scenz-dev/superpico-digital/hardware/interface_v2/bias.kicad_sch

## KiCad design hardware/interface_v2/bias.kicad_sch (2026-11-12)

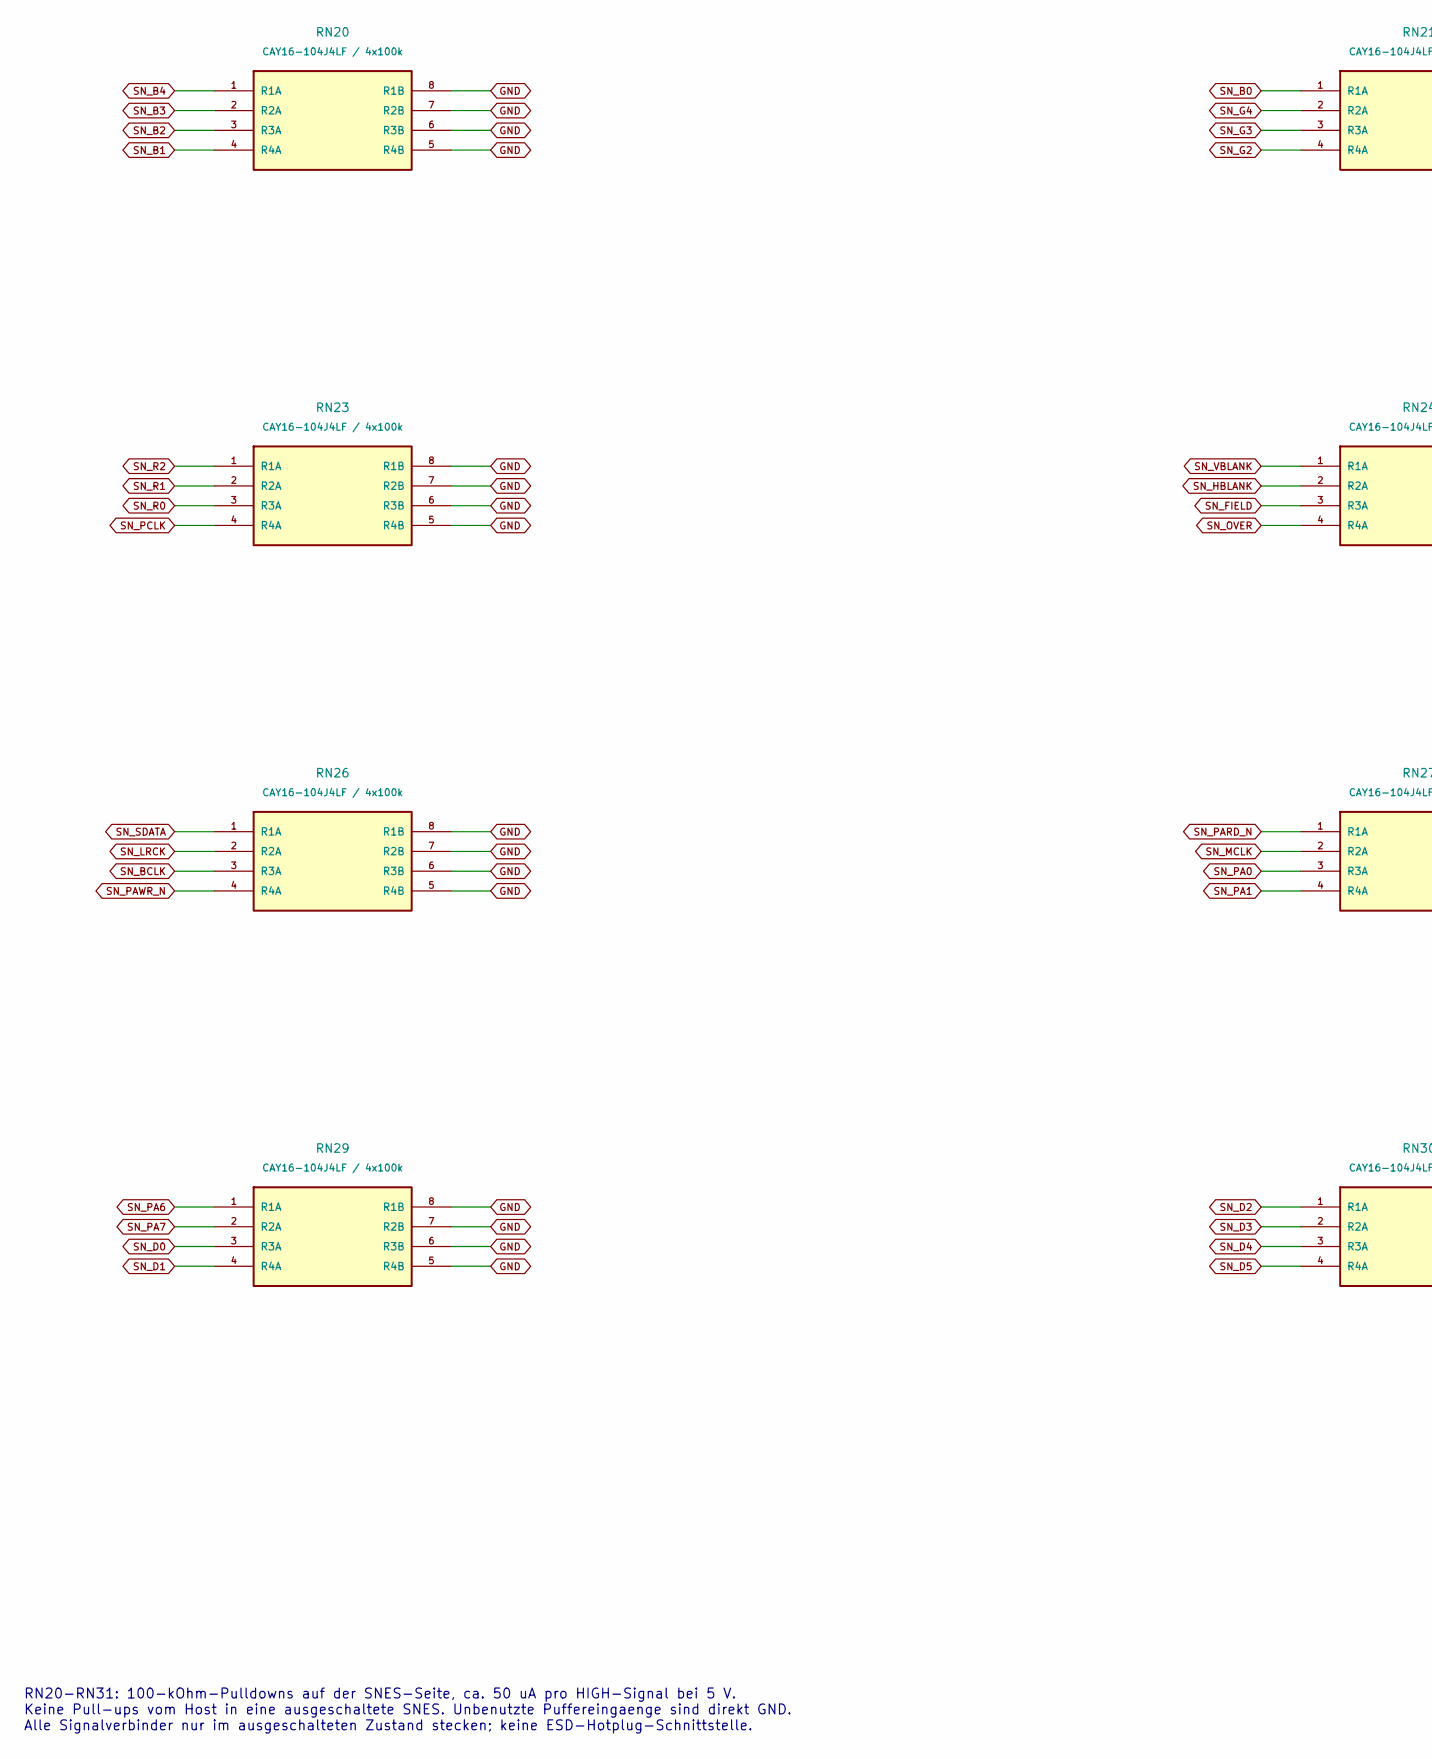
[picture p1: schematic bias.kicad_sch, part in row 1, column 1]

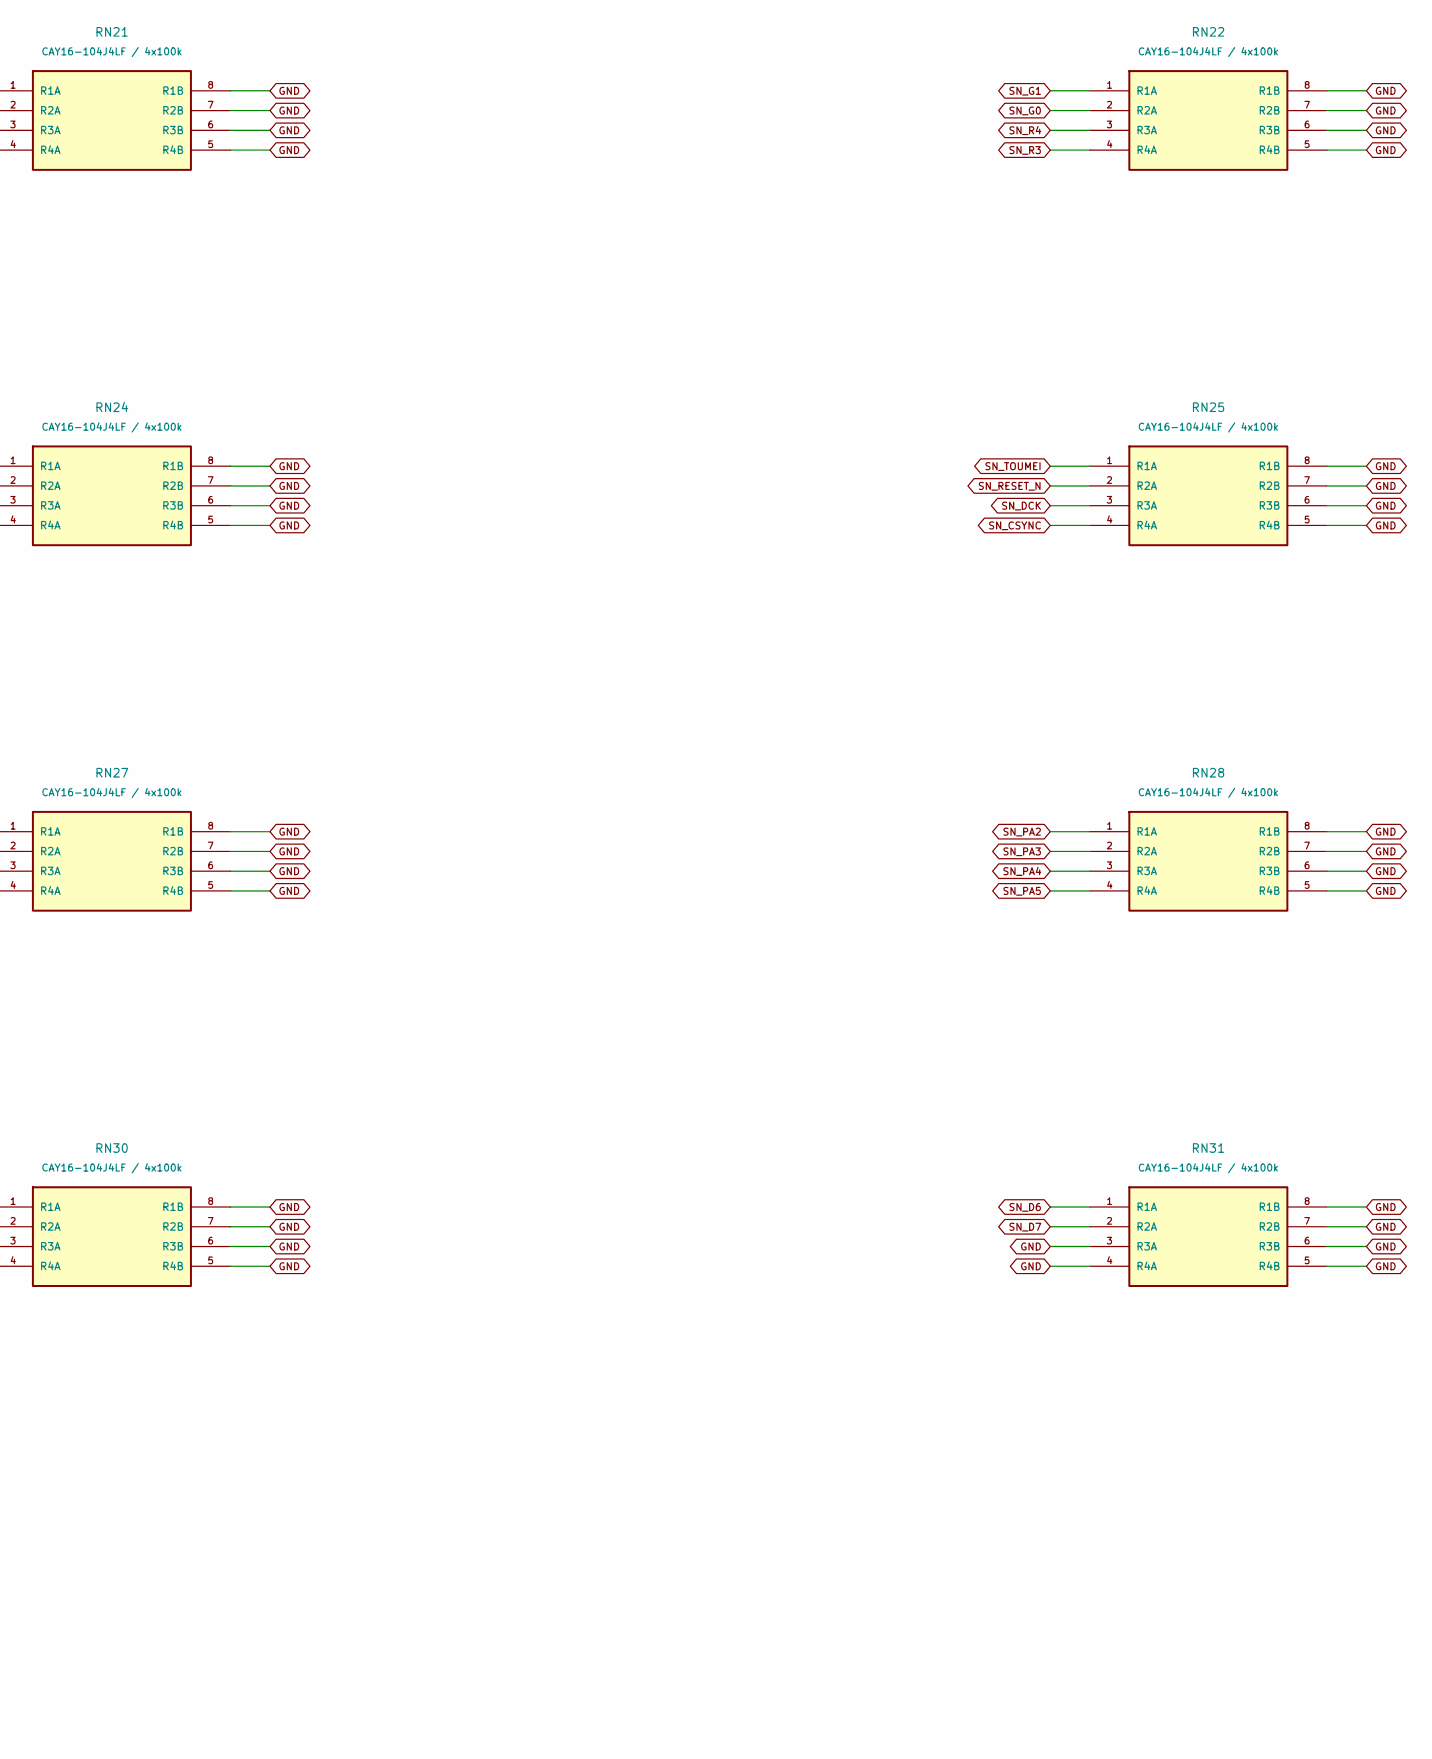
[picture p2: schematic bias.kicad_sch, part in row 1, column 2]

Parts:
RN20, RN21, RN22, RN23, RN24, RN25, RN26, RN27, RN28, RN29, RN30, RN31: CAY16-104J4LF / 4x100k; R_Array_Convex_4x0603

Connections:
GND: RN20.5 (R4B), RN20.6 (R3B), RN20.7 (R2B), RN20.8 (R1B), RN21.5 (R4B), RN21.6 (R3B), RN21.7 (R2B), RN21.8 (R1B), RN22.5 (R4B), RN22.6 (R3B), RN22.7 (R2B), RN22.8 (R1B), RN23.5 (R4B), RN23.6 (R3B), RN23.7 (R2B), RN23.8 (R1B), RN24.5 (R4B), RN24.6 (R3B), RN24.7 (R2B), RN24.8 (R1B), RN25.5 (R4B), RN25.6 (R3B), RN25.7 (R2B), RN25.8 (R1B), RN26.5 (R4B), RN26.6 (R3B), RN26.7 (R2B), RN26.8 (R1B), RN27.5 (R4B), RN27.6 (R3B), RN27.7 (R2B), RN27.8 (R1B), RN28.5 (R4B), RN28.6 (R3B), RN28.7 (R2B), RN28.8 (R1B), RN29.5 (R4B), RN29.6 (R3B), RN29.7 (R2B), RN29.8 (R1B), RN30.5 (R4B), RN30.6 (R3B), RN30.7 (R2B), RN30.8 (R1B), RN31.3 (R3A), RN31.4 (R4A), RN31.5 (R4B), RN31.6 (R3B), RN31.7 (R2B), RN31.8 (R1B)
SN_B0: RN21.1 (R1A)
SN_B1: RN20.4 (R4A)
SN_B2: RN20.3 (R3A)
SN_B3: RN20.2 (R2A)
SN_B4: RN20.1 (R1A)
SN_BCLK: RN26.3 (R3A)
SN_CSYNC: RN25.4 (R4A)
SN_D0: RN29.3 (R3A)
SN_D1: RN29.4 (R4A)
SN_D2: RN30.1 (R1A)
SN_D3: RN30.2 (R2A)
SN_D4: RN30.3 (R3A)
SN_D5: RN30.4 (R4A)
SN_D6: RN31.1 (R1A)
SN_D7: RN31.2 (R2A)
SN_DCK: RN25.3 (R3A)
SN_FIELD: RN24.3 (R3A)
SN_G0: RN22.2 (R2A)
SN_G1: RN22.1 (R1A)
SN_G2: RN21.4 (R4A)
SN_G3: RN21.3 (R3A)
SN_G4: RN21.2 (R2A)
SN_HBLANK: RN24.2 (R2A)
SN_LRCK: RN26.2 (R2A)
SN_MCLK: RN27.2 (R2A)
SN_OVER: RN24.4 (R4A)
SN_PA0: RN27.3 (R3A)
SN_PA1: RN27.4 (R4A)
SN_PA2: RN28.1 (R1A)
SN_PA3: RN28.2 (R2A)
SN_PA4: RN28.3 (R3A)
SN_PA5: RN28.4 (R4A)
SN_PA6: RN29.1 (R1A)
SN_PA7: RN29.2 (R2A)
SN_PARD_N: RN27.1 (R1A)
SN_PAWR_N: RN26.4 (R4A)
SN_PCLK: RN23.4 (R4A)
SN_R0: RN23.3 (R3A)
SN_R1: RN23.2 (R2A)
SN_R2: RN23.1 (R1A)
SN_R3: RN22.4 (R4A)
SN_R4: RN22.3 (R3A)
SN_RESET_N: RN25.2 (R2A)
SN_SDATA: RN26.1 (R1A)
SN_TOUMEI: RN25.1 (R1A)
SN_VBLANK: RN24.1 (R1A)

Notes on the sheet:
RN20-RN31: 100-kOhm-Pulldowns auf der SNES-Seite, ca. 50 uA pro HIGH-Signal bei 5 V. Keine Pull-ups vom Host in eine ausgeschaltete SNES. Unbenutzte Puffereingaenge sind direkt GND. Alle Signalverbinder nur im ausgeschalteten Zustand stecken; keine ESD-Hotplug-Schnittstelle.
