scenz-dev/superpico-digital/hardware/interface_v2/bus.kicad_sch

## KiCad design hardware/interface_v2/bus.kicad_sch (2026-11-12)

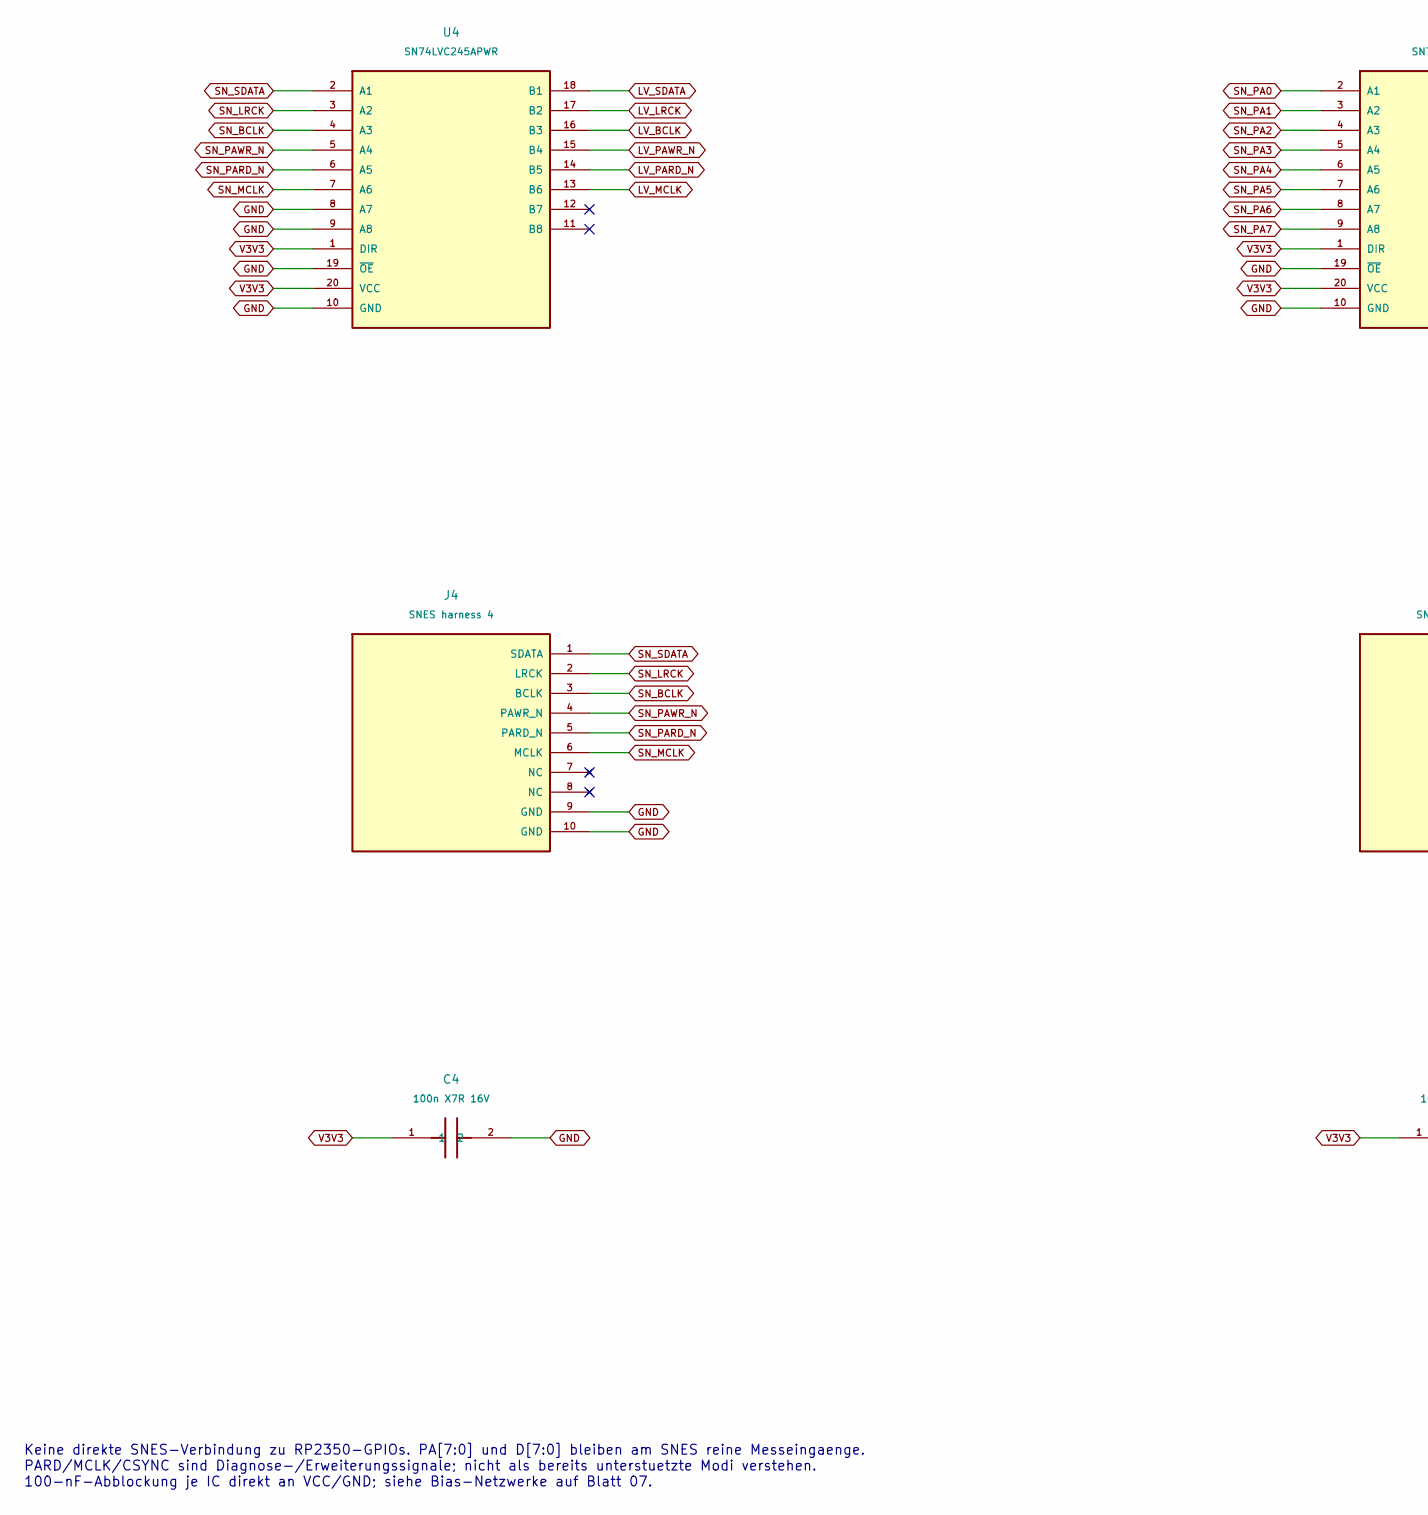
[picture p3: schematic bus.kicad_sch, part in row 1, column 1]

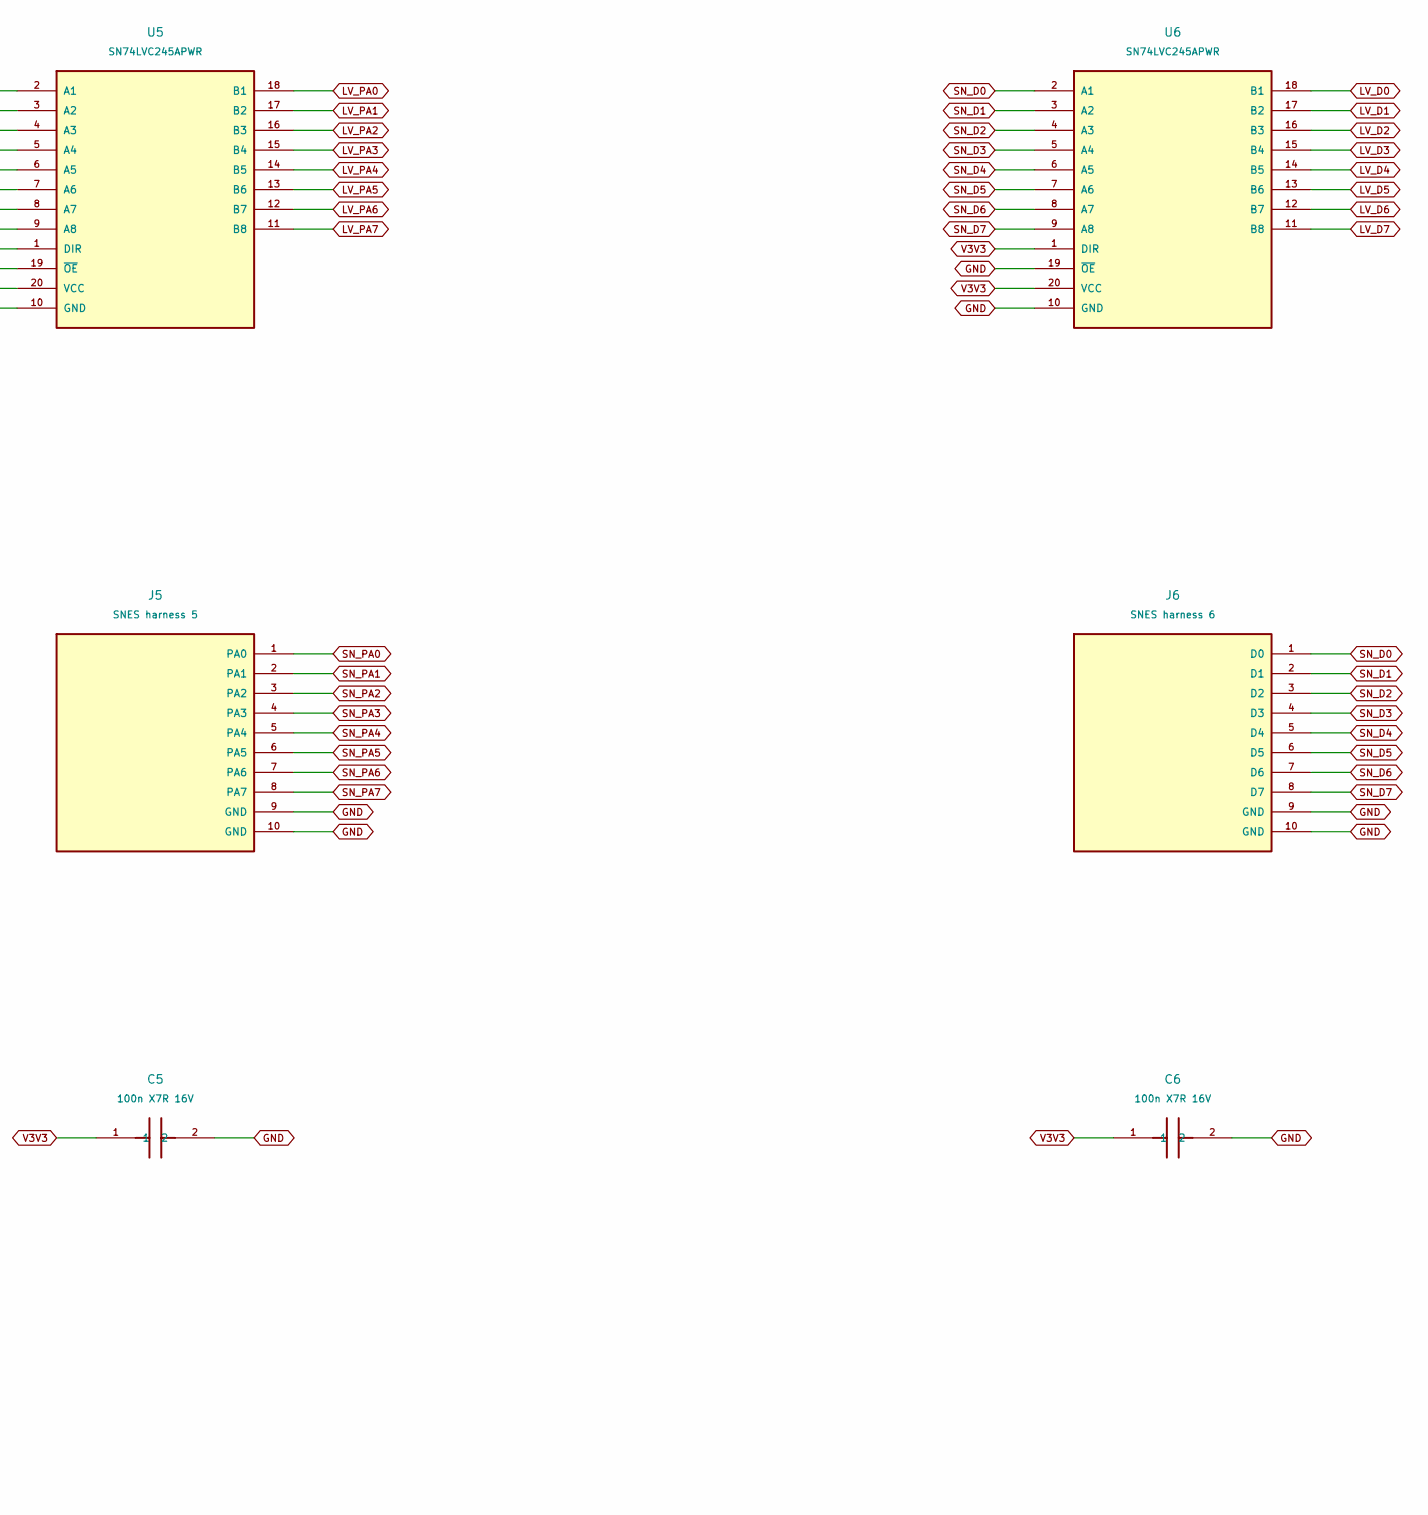
[picture p4: schematic bus.kicad_sch, part in row 1, column 2]

Parts:
C4, C5, C6: 100n X7R 16V; C_0603_1608Metric
J4: SNES harness 4; PinHeader_2x05_P2.54mm_Vertical
J5: SNES harness 5; PinHeader_2x05_P2.54mm_Vertical
J6: SNES harness 6; PinHeader_2x05_P2.54mm_Vertical
U4, U5, U6: SN74LVC245APWR; TSSOP-20_4.4x6.5mm_P0.65mm

Connections:
GND: C4.2, C5.2, C6.2, J4.9 (GND), J4.10 (GND), J5.9 (GND), J5.10 (GND), J6.9 (GND), J6.10 (GND), U4.8 (A7), U4.9 (A8), U4.10 (GND), U4.19 (~OE), U5.10 (GND), U5.19 (~OE), U6.10 (GND), U6.19 (~OE)
LV_BCLK: U4.16 (B3)
LV_D0: U6.18 (B1)
LV_D1: U6.17 (B2)
LV_D2: U6.16 (B3)
LV_D3: U6.15 (B4)
LV_D4: U6.14 (B5)
LV_D5: U6.13 (B6)
LV_D6: U6.12 (B7)
LV_D7: U6.11 (B8)
LV_LRCK: U4.17 (B2)
LV_MCLK: U4.13 (B6)
LV_PA0: U5.18 (B1)
LV_PA1: U5.17 (B2)
LV_PA2: U5.16 (B3)
LV_PA3: U5.15 (B4)
LV_PA4: U5.14 (B5)
LV_PA5: U5.13 (B6)
LV_PA6: U5.12 (B7)
LV_PA7: U5.11 (B8)
LV_PARD_N: U4.14 (B5)
LV_PAWR_N: U4.15 (B4)
LV_SDATA: U4.18 (B1)
SN_BCLK: J4.3 (BCLK), U4.4 (A3)
SN_D0: J6.1 (D0), U6.2 (A1)
SN_D1: J6.2 (D1), U6.3 (A2)
SN_D2: J6.3 (D2), U6.4 (A3)
SN_D3: J6.4 (D3), U6.5 (A4)
SN_D4: J6.5 (D4), U6.6 (A5)
SN_D5: J6.6 (D5), U6.7 (A6)
SN_D6: J6.7 (D6), U6.8 (A7)
SN_D7: J6.8 (D7), U6.9 (A8)
SN_LRCK: J4.2 (LRCK), U4.3 (A2)
SN_MCLK: J4.6 (MCLK), U4.7 (A6)
SN_PA0: J5.1 (PA0), U5.2 (A1)
SN_PA1: J5.2 (PA1), U5.3 (A2)
SN_PA2: J5.3 (PA2), U5.4 (A3)
SN_PA3: J5.4 (PA3), U5.5 (A4)
SN_PA4: J5.5 (PA4), U5.6 (A5)
SN_PA5: J5.6 (PA5), U5.7 (A6)
SN_PA6: J5.7 (PA6), U5.8 (A7)
SN_PA7: J5.8 (PA7), U5.9 (A8)
SN_PARD_N: J4.5 (PARD_N), U4.6 (A5)
SN_PAWR_N: J4.4 (PAWR_N), U4.5 (A4)
SN_SDATA: J4.1 (SDATA), U4.2 (A1)
V3V3: C4.1, C5.1, C6.1, U4.1 (DIR), U4.20 (VCC), U5.1 (DIR), U5.20 (VCC), U6.1 (DIR), U6.20 (VCC)

Notes on the sheet:
Keine direkte SNES-Verbindung zu RP2350-GPIOs. PA[7:0] und D[7:0] bleiben am SNES reine Messeingaenge. PARD/MCLK/CSYNC sind Diagnose-/Erweiterungssignale; nicht als bereits unterstuetzte Modi verstehen. 100-nF-Abblockung je IC direkt an VCC/GND; siehe Bias-Netzwerke auf Blatt 07.
