scenz-dev/superpico-digital/hardware/interface_v2/decode.kicad_sch

## KiCad design hardware/interface_v2/decode.kicad_sch (2026-11-12)

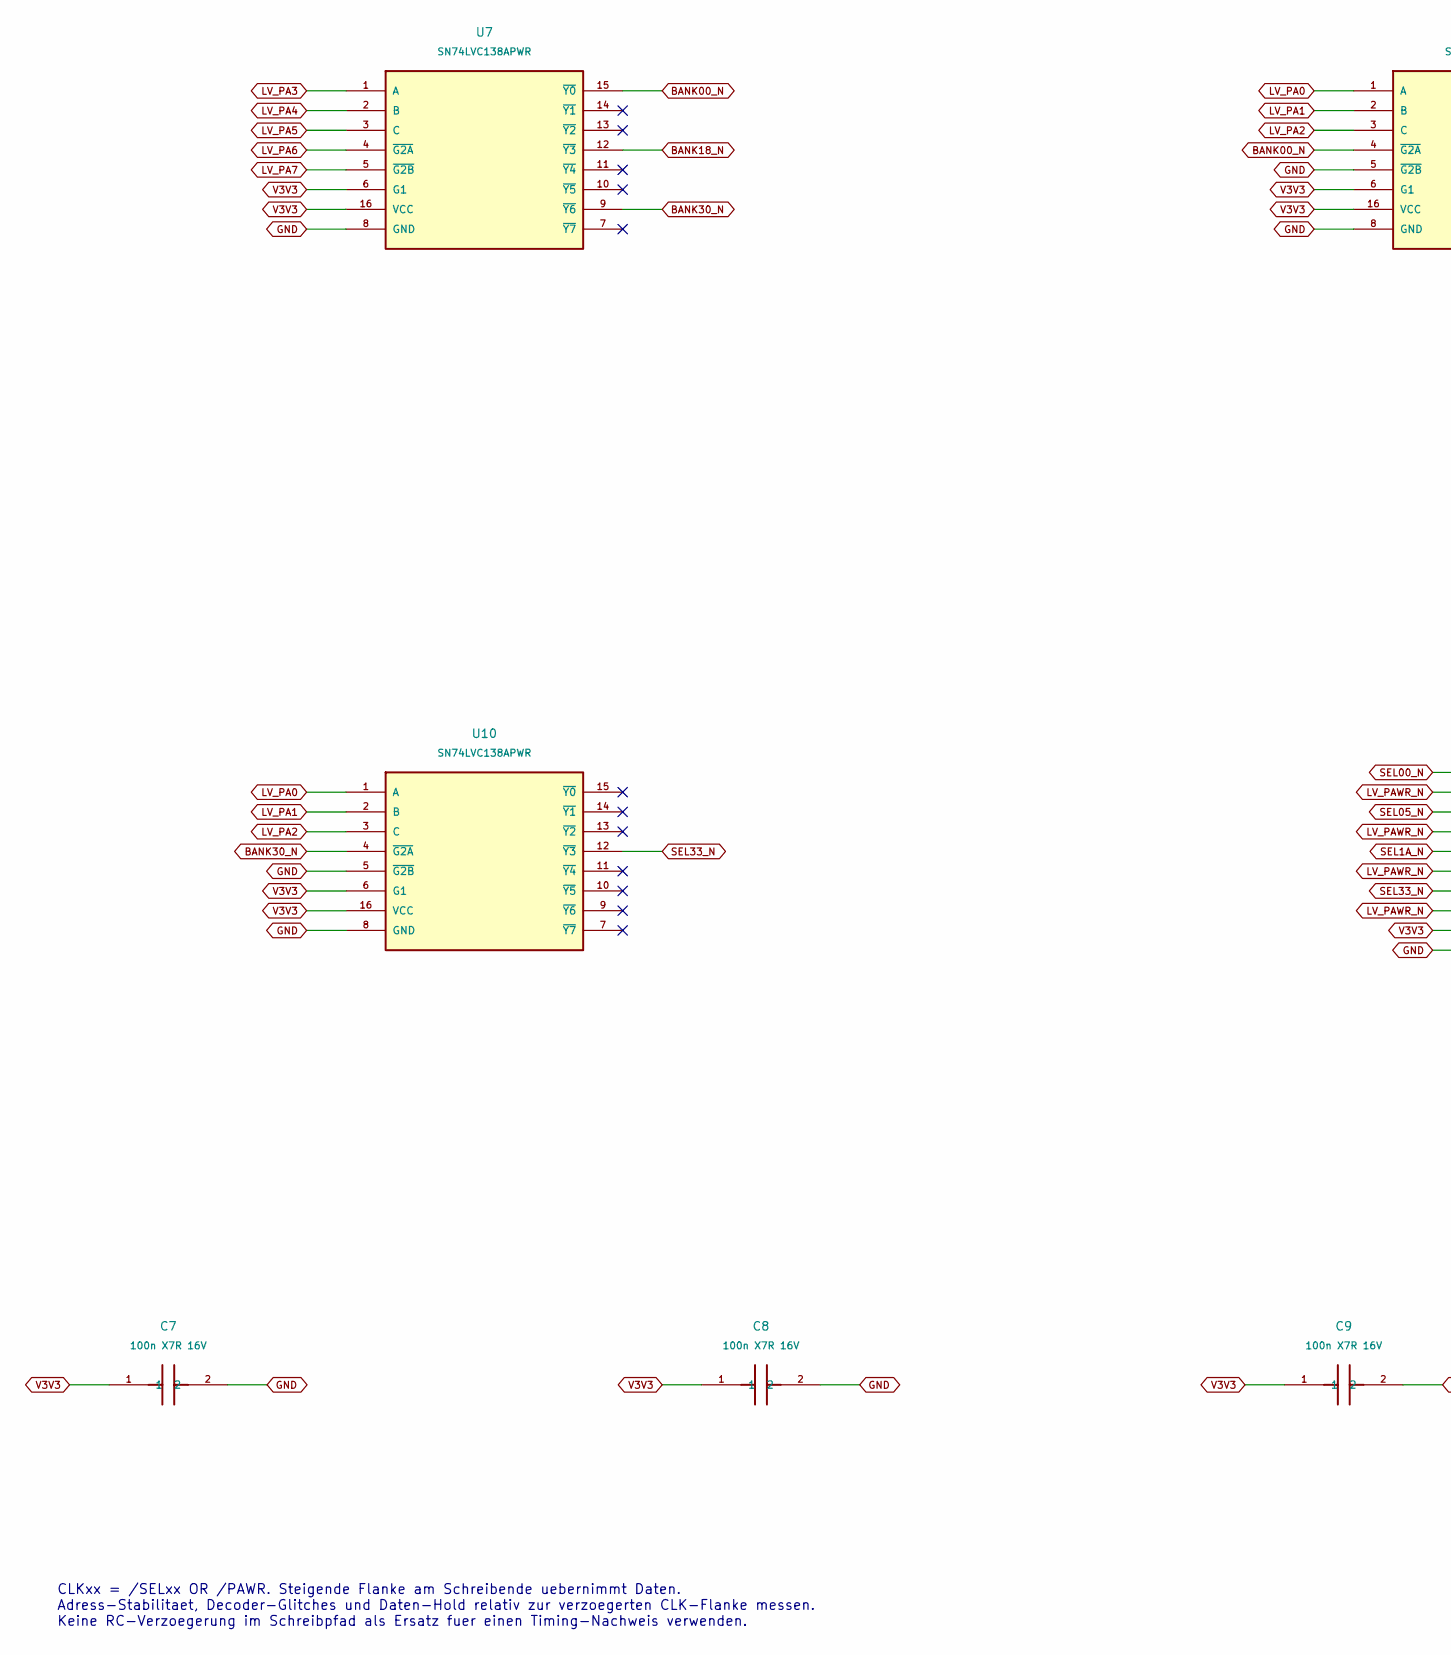
[picture p5: schematic decode.kicad_sch, part in row 1, column 1]

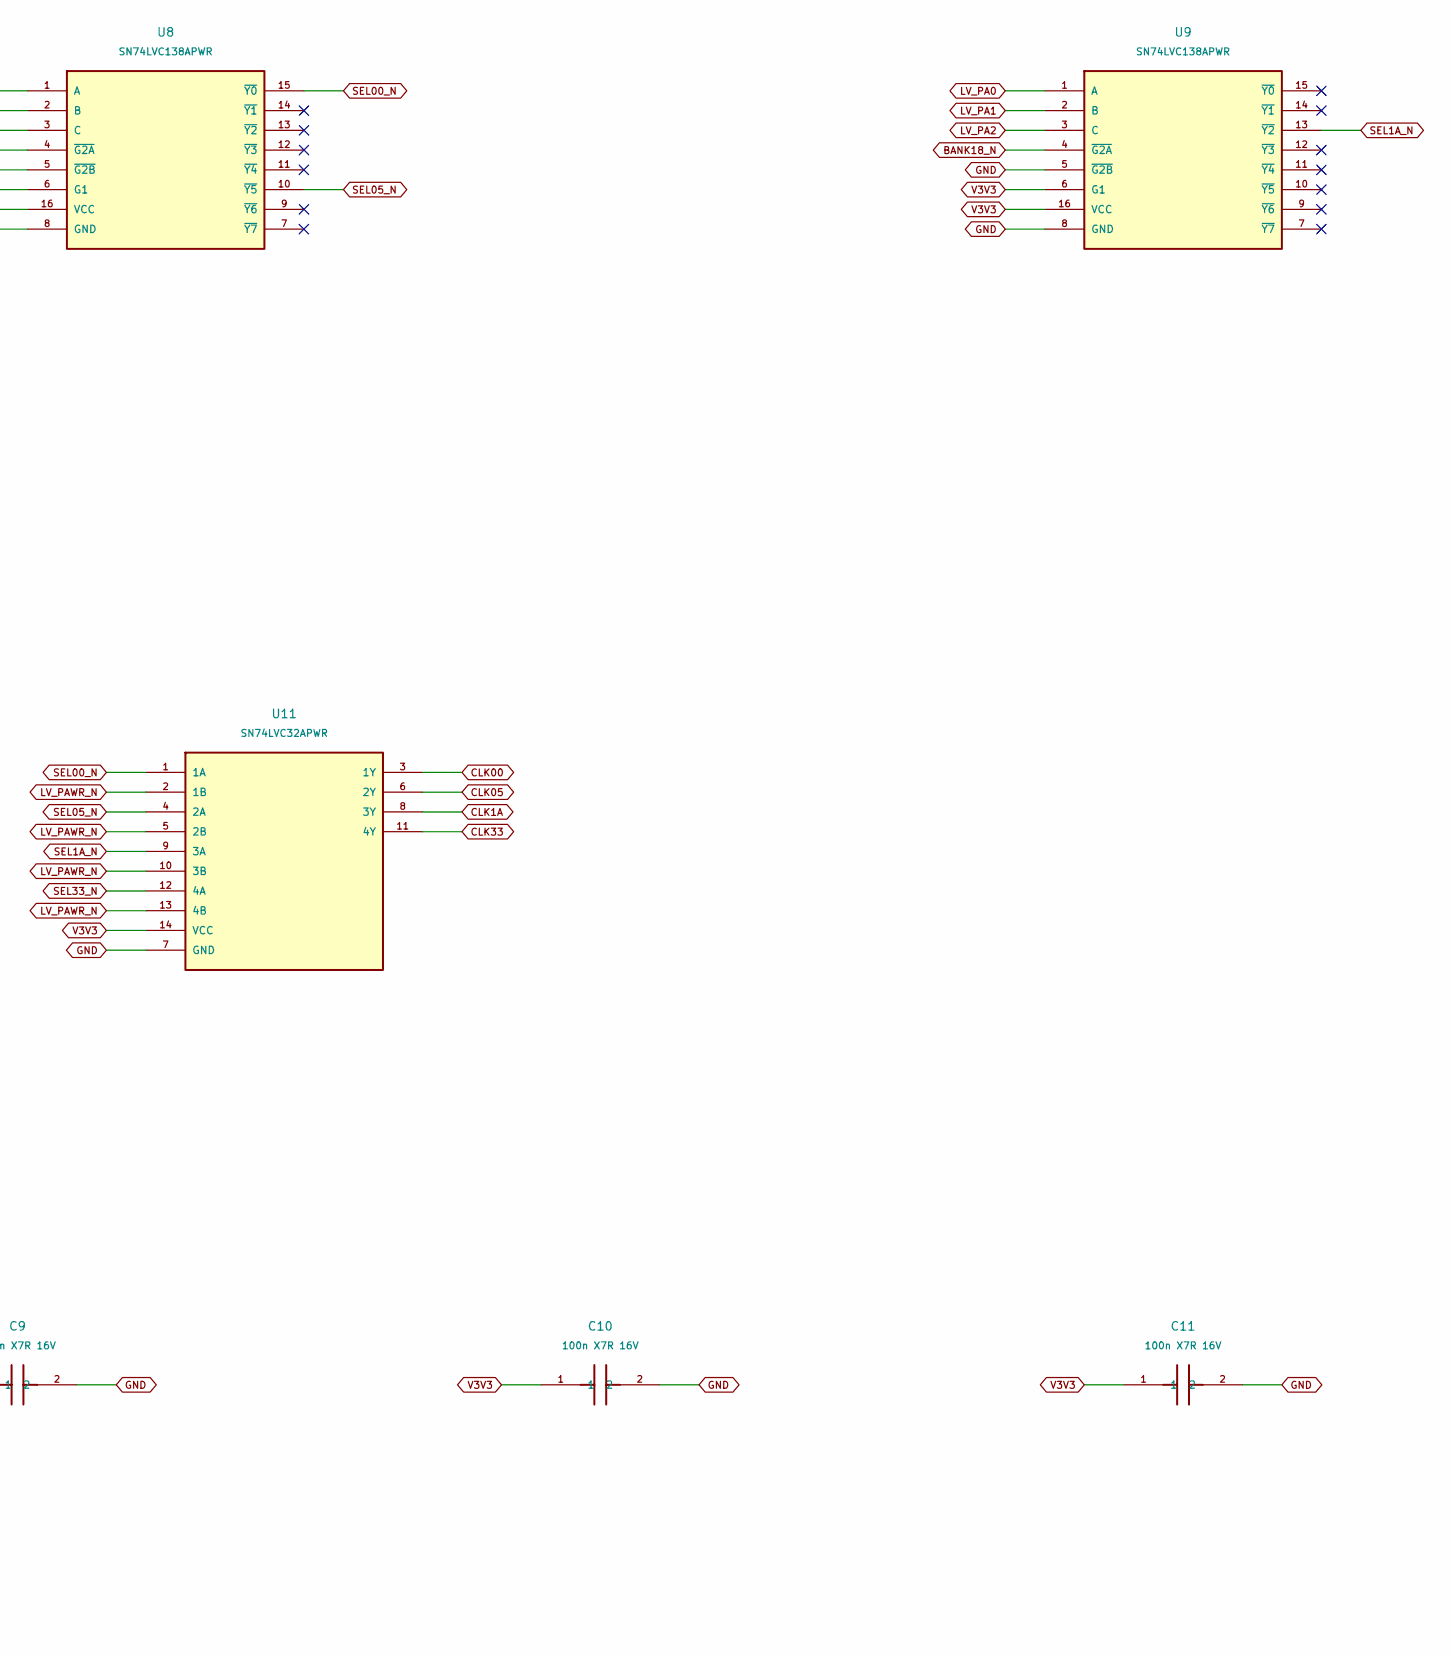
[picture p6: schematic decode.kicad_sch, part in row 1, column 2]

Parts:
C7, C8, C9, C10, C11: 100n X7R 16V; C_0603_1608Metric
U7, U8, U9, U10: SN74LVC138APWR; TSSOP-16_4.4x5mm_P0.65mm
U11: SN74LVC32APWR; TSSOP-14_4.4x5mm_P0.65mm

Connections:
BANK00_N: U7.15 (~Y0), U8.4 (~G2A)
BANK18_N: U7.12 (~Y3), U9.4 (~G2A)
BANK30_N: U7.9 (~Y6), U10.4 (~G2A)
CLK00: U11.3 (1Y)
CLK1A: U11.8 (3Y)
CLK05: U11.6 (2Y)
CLK33: U11.11 (4Y)
GND: C7.2, C8.2, C9.2, C10.2, C11.2, U7.8 (GND), U8.5 (~G2B), U8.8 (GND), U9.5 (~G2B), U9.8 (GND), U10.5 (~G2B), U10.8 (GND), U11.7 (GND)
LV_PA0: U8.1 (A), U9.1 (A), U10.1 (A)
LV_PA1: U8.2 (B), U9.2 (B), U10.2 (B)
LV_PA2: U8.3 (C), U9.3 (C), U10.3 (C)
LV_PA3: U7.1 (A)
LV_PA4: U7.2 (B)
LV_PA5: U7.3 (C)
LV_PA6: U7.4 (~G2A)
LV_PA7: U7.5 (~G2B)
LV_PAWR_N: U11.2 (1B), U11.5 (2B), U11.10 (3B), U11.13 (4B)
SEL00_N: U8.15 (~Y0), U11.1 (1A)
SEL1A_N: U9.13 (~Y2), U11.9 (3A)
SEL05_N: U8.10 (~Y5), U11.4 (2A)
SEL33_N: U10.12 (~Y3), U11.12 (4A)
V3V3: C7.1, C8.1, C9.1, C10.1, C11.1, U7.6 (G1), U7.16 (VCC), U8.6 (G1), U8.16 (VCC), U9.6 (G1), U9.16 (VCC), U10.6 (G1), U10.16 (VCC), U11.14 (VCC)

Notes on the sheet:
CLKxx = /SELxx OR /PAWR. Steigende Flanke am Schreibende uebernimmt Daten. Adress-Stabilitaet, Decoder-Glitches und Daten-Hold relativ zur verzoegerten CLK-Flanke messen. Keine RC-Verzoegerung im Schreibpfad als Ersatz fuer einen Timing-Nachweis verwenden.
