scenz-dev/superpico-digital/hardware/interface_v2/host.kicad_sch

## KiCad design hardware/interface_v2/host.kicad_sch (2026-11-12)

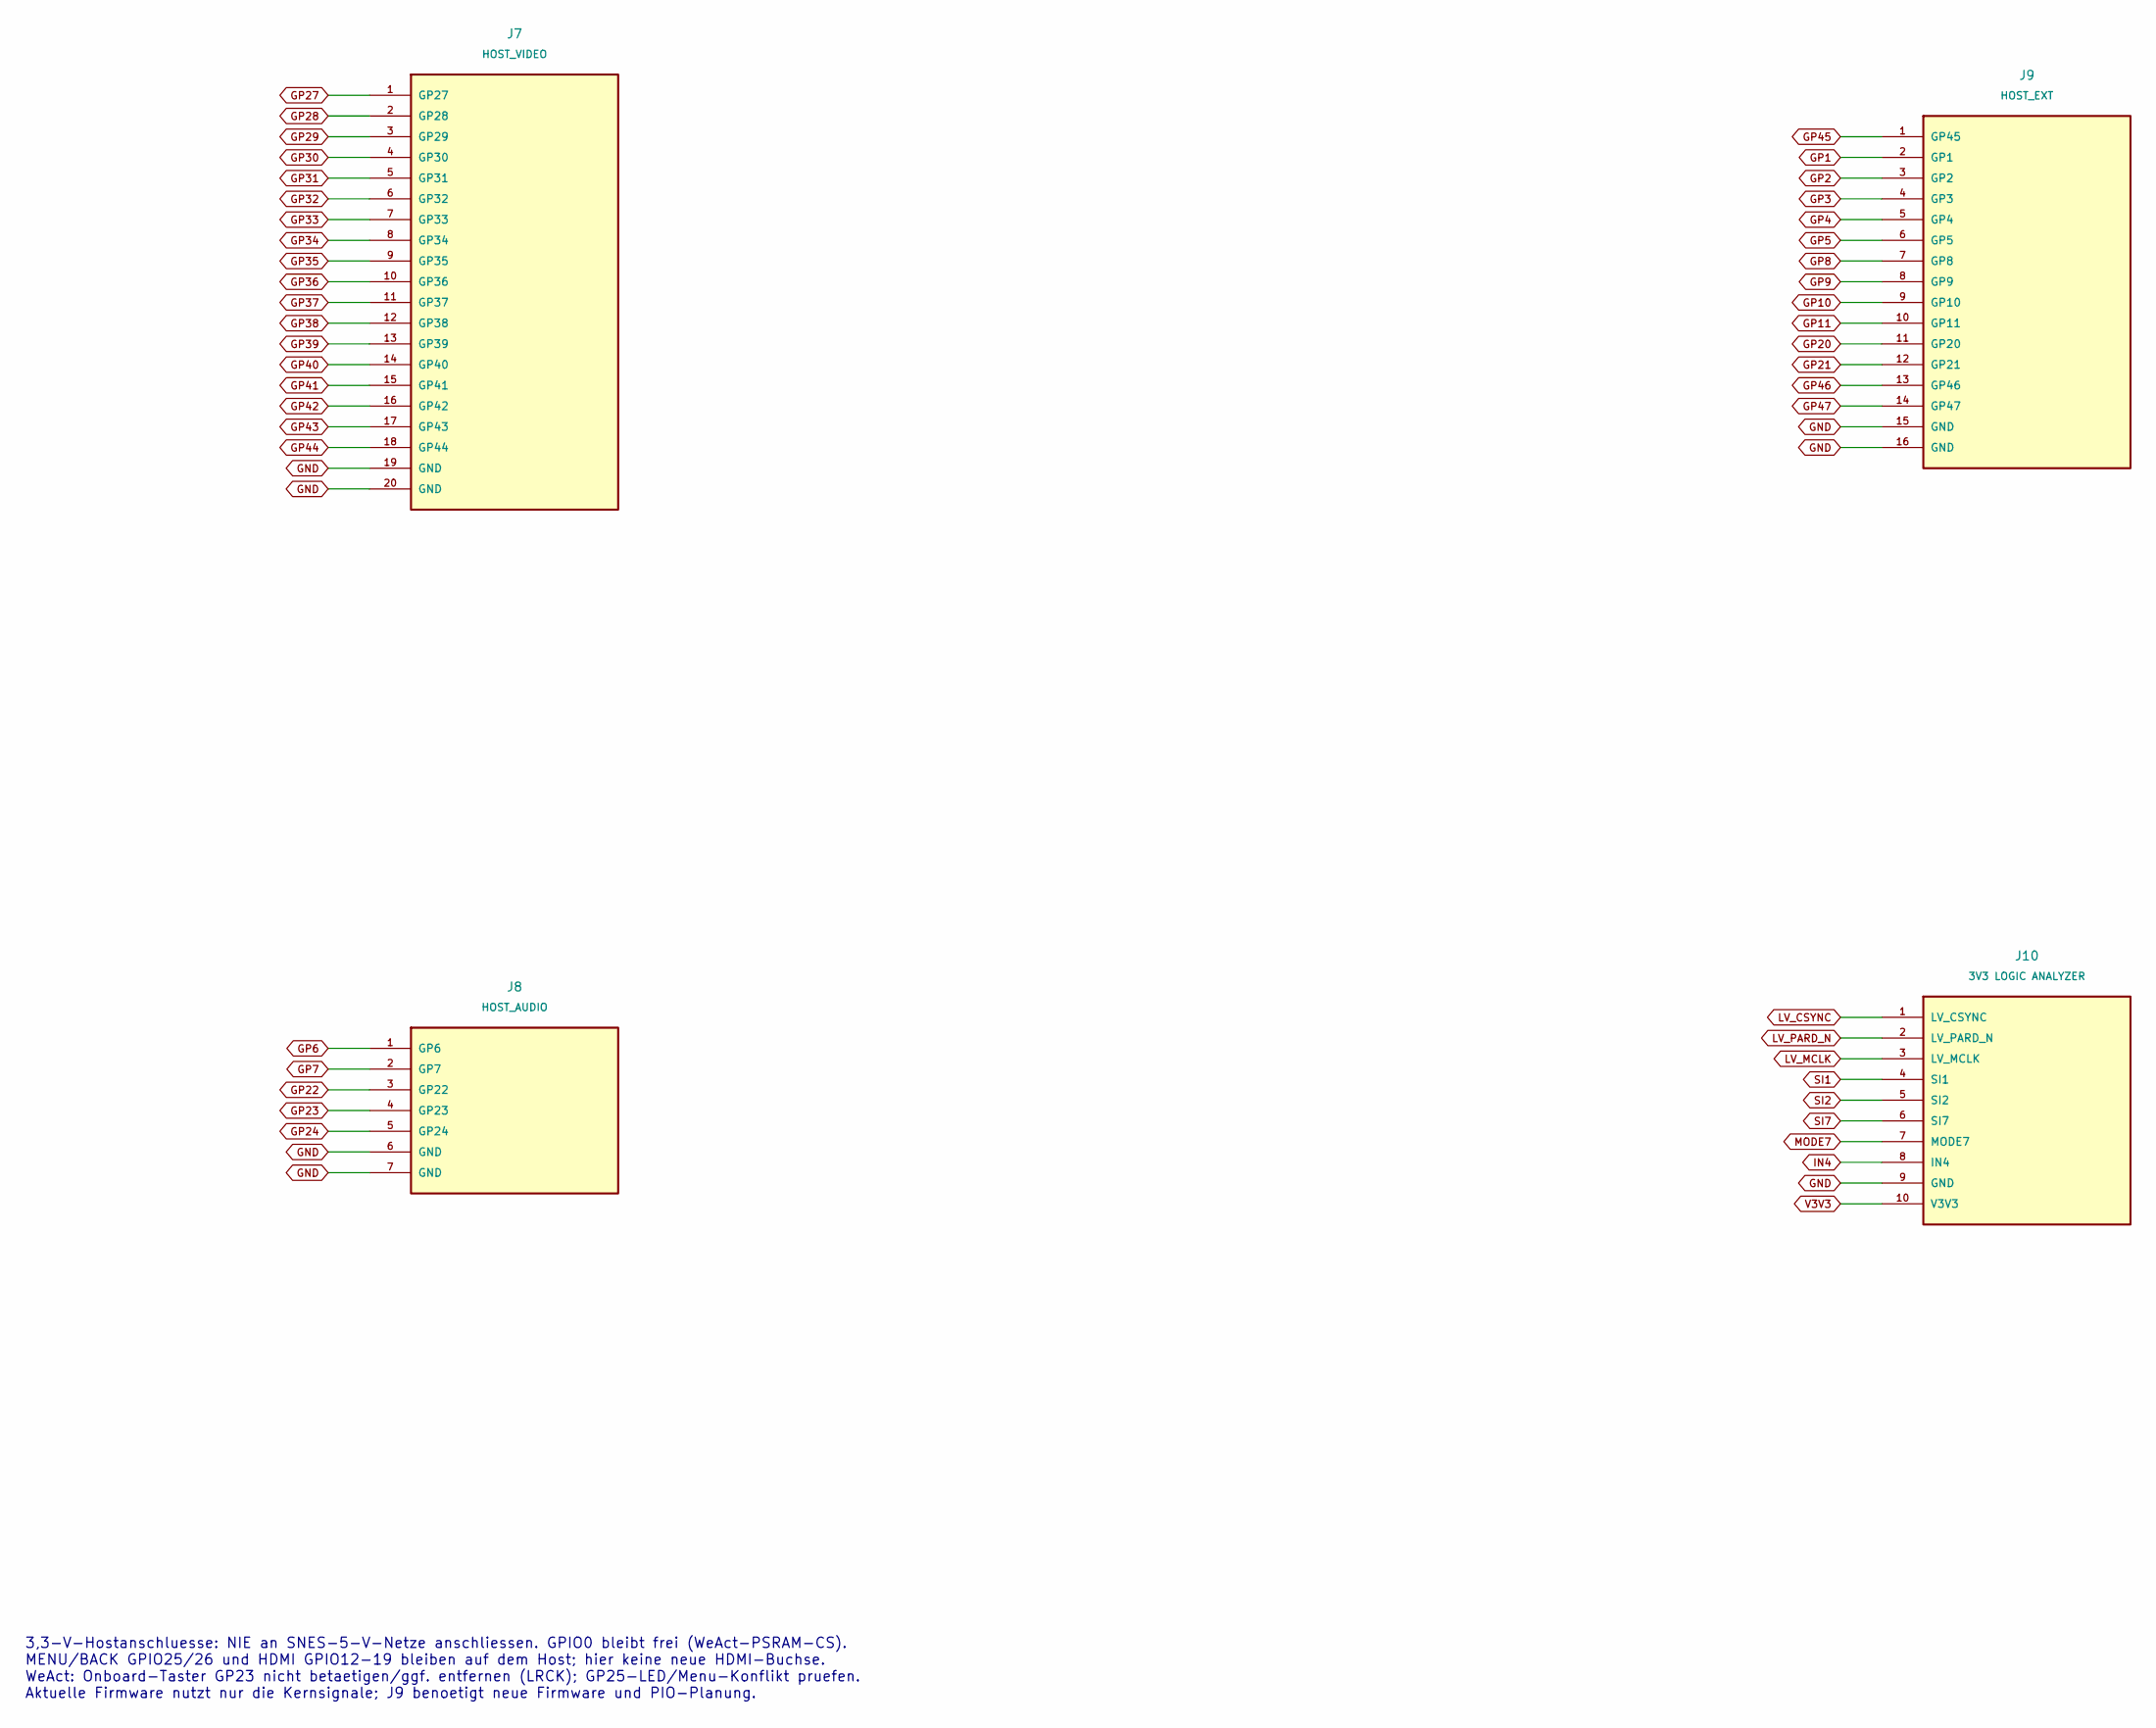
[picture p7: schematic host.kicad_sch]

Parts:
J7: HOST_VIDEO; PinHeader_2x10_P2.54mm_Vertical
J8: HOST_AUDIO; PinHeader_1x07_P2.54mm_Vertical
J9: HOST_EXT; PinHeader_2x08_P2.54mm_Vertical
J10: 3V3 LOGIC ANALYZER; PinHeader_2x05_P2.54mm_Vertical

Connections:
GND: J7.19 (GND), J7.20 (GND), J8.6 (GND), J8.7 (GND), J9.15 (GND), J9.16 (GND), J10.9 (GND)
GP1: J9.2 (GP1)
GP2: J9.3 (GP2)
GP3: J9.4 (GP3)
GP4: J9.5 (GP4)
GP5: J9.6 (GP5)
GP6: J8.1 (GP6)
GP7: J8.2 (GP7)
GP8: J9.7 (GP8)
GP9: J9.8 (GP9)
GP10: J9.9 (GP10)
GP11: J9.10 (GP11)
GP20: J9.11 (GP20)
GP21: J9.12 (GP21)
GP22: J8.3 (GP22)
GP23: J8.4 (GP23)
GP24: J8.5 (GP24)
GP27: J7.1 (GP27)
GP28: J7.2 (GP28)
GP29: J7.3 (GP29)
GP30: J7.4 (GP30)
GP31: J7.5 (GP31)
GP32: J7.6 (GP32)
GP33: J7.7 (GP33)
GP34: J7.8 (GP34)
GP35: J7.9 (GP35)
GP36: J7.10 (GP36)
GP37: J7.11 (GP37)
GP38: J7.12 (GP38)
GP39: J7.13 (GP39)
GP40: J7.14 (GP40)
GP41: J7.15 (GP41)
GP42: J7.16 (GP42)
GP43: J7.17 (GP43)
GP44: J7.18 (GP44)
GP45: J9.1 (GP45)
GP46: J9.13 (GP46)
GP47: J9.14 (GP47)
IN4: J10.8 (IN4)
LV_CSYNC: J10.1 (LV_CSYNC)
LV_MCLK: J10.3 (LV_MCLK)
LV_PARD_N: J10.2 (LV_PARD_N)
MODE7: J10.7 (MODE7)
SI1: J10.4 (SI1)
SI2: J10.5 (SI2)
SI7: J10.6 (SI7)
V3V3: J10.10 (V3V3)

Notes on the sheet:
3,3-V-Hostanschluesse: NIE an SNES-5-V-Netze anschliessen. GPIO0 bleibt frei (WeAct-PSRAM-CS). MENU/BACK GPIO25/26 und HDMI GPIO12-19 bleiben auf dem Host; hier keine neue HDMI-Buchse. WeAct: Onboard-Taster GP23 nicht betaetigen/ggf. entfernen (LRCK); GP25-LED/Menu-Konflikt pruefen. Aktuelle Firmwa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
