scenz-dev/superpico-digital/hardware/interface_v2/latches.kicad_sch

## KiCad design hardware/interface_v2/latches.kicad_sch (2026-11-12)

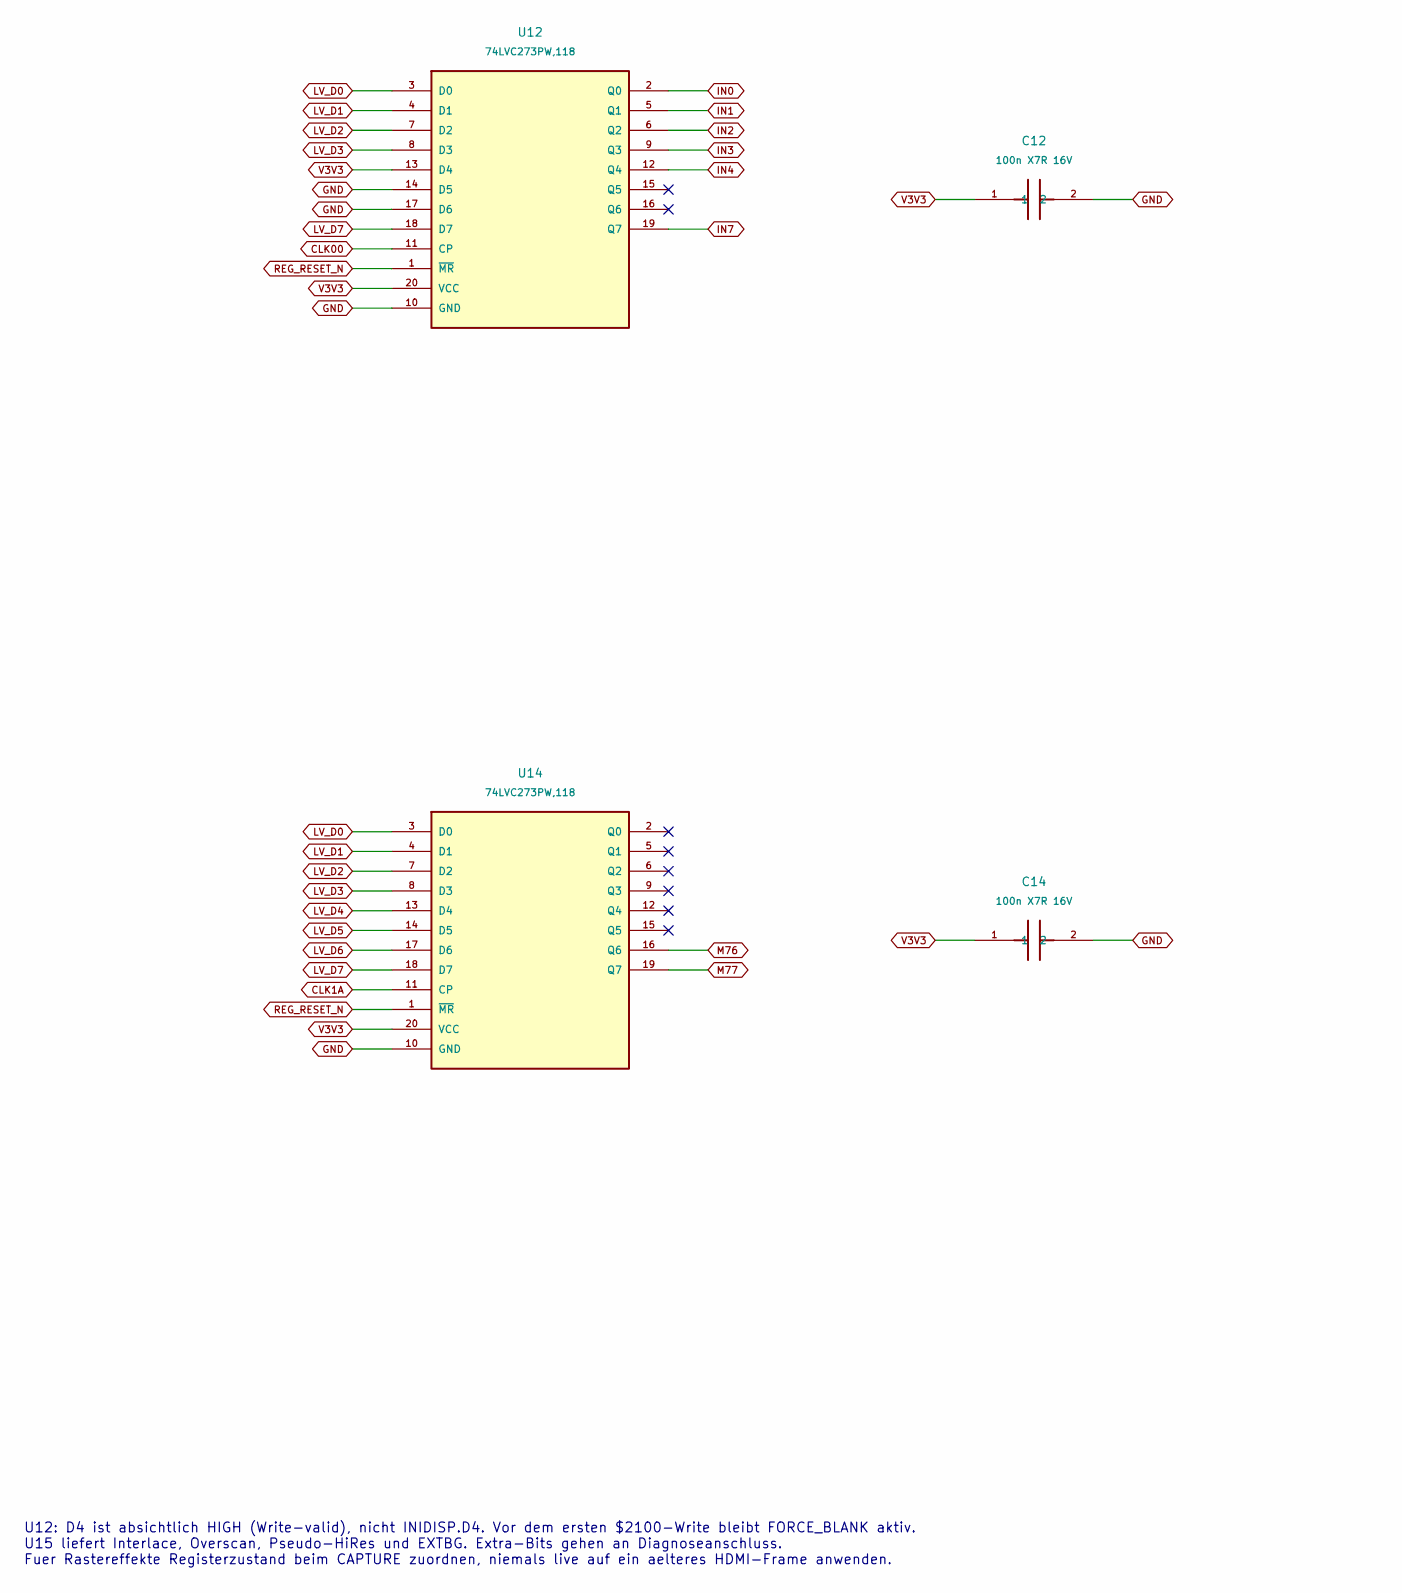
[picture p8: schematic latches.kicad_sch, part in row 1, column 1]

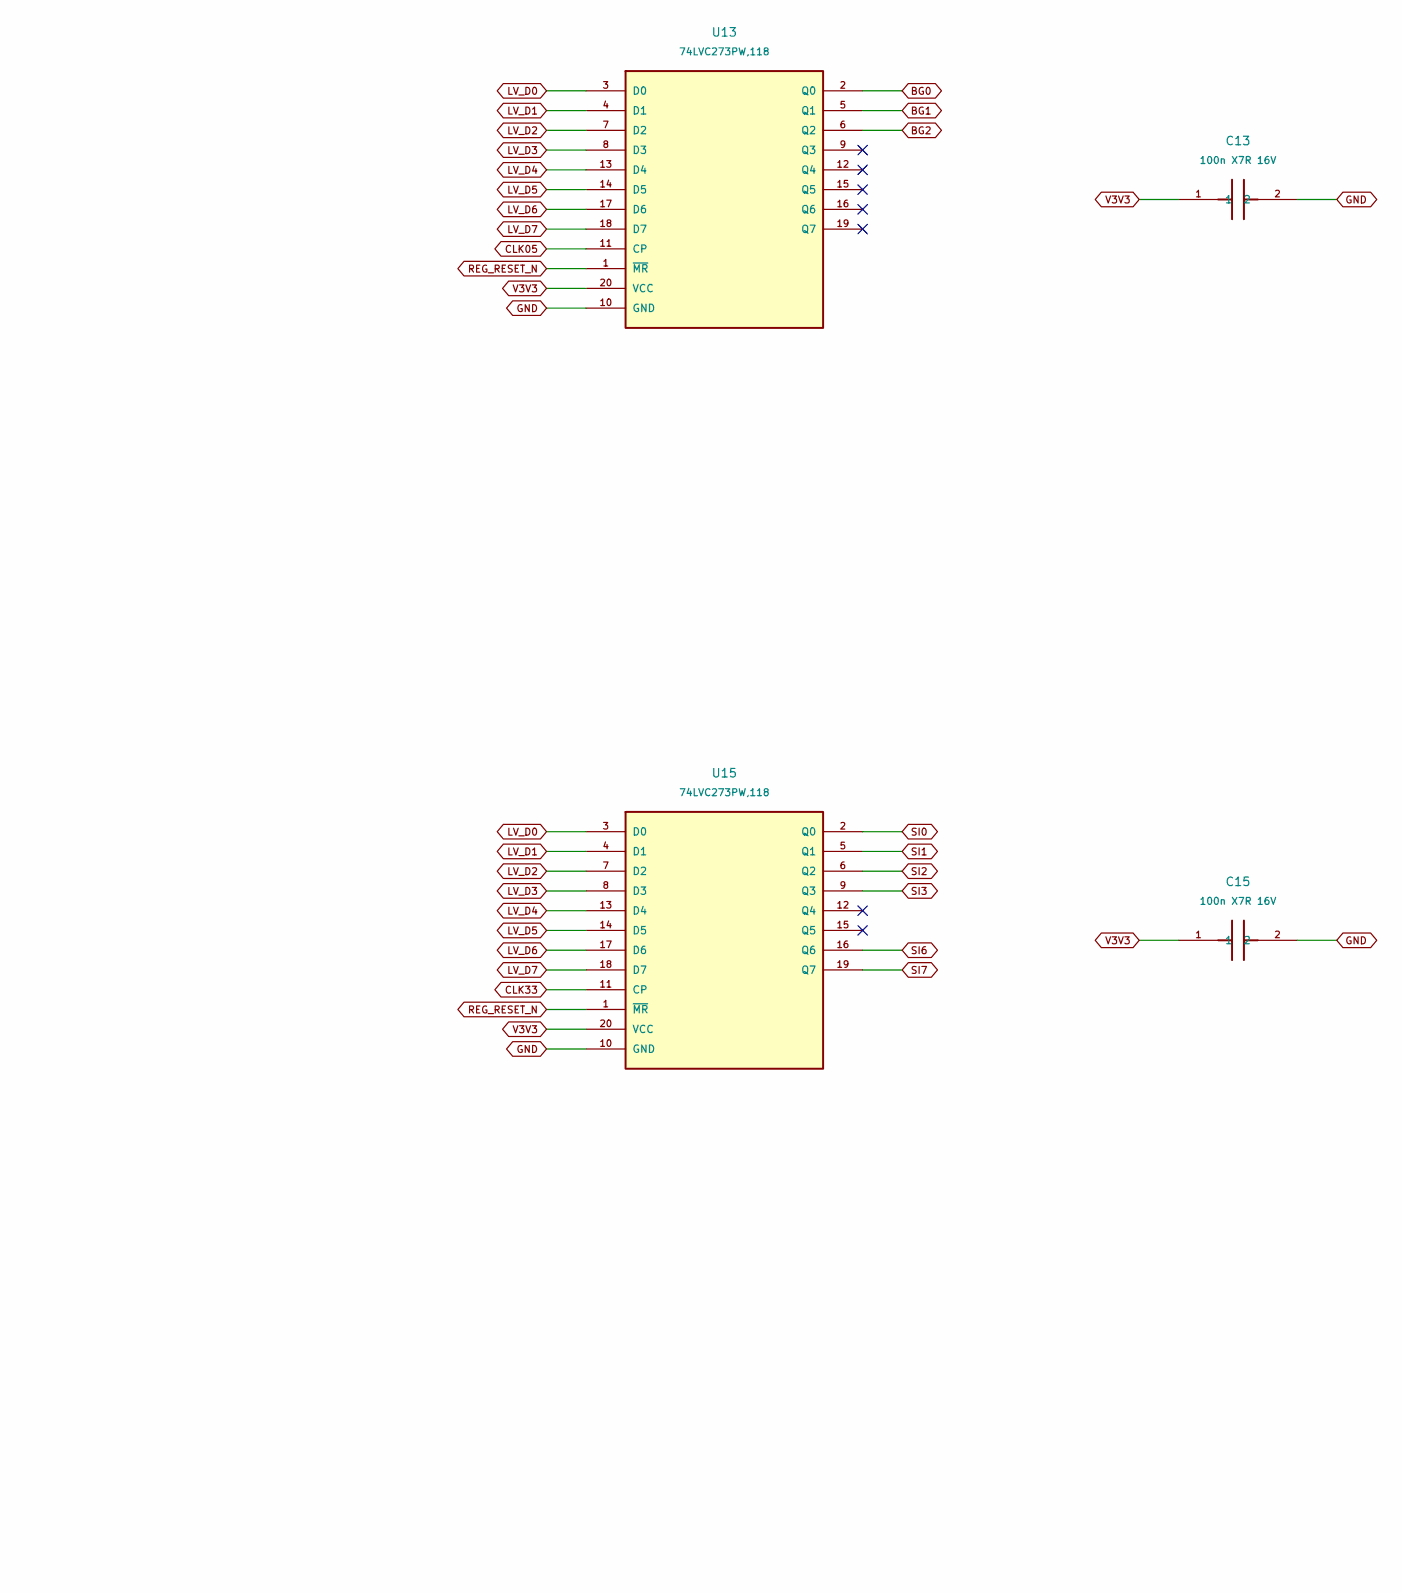
[picture p9: schematic latches.kicad_sch, part in row 1, column 2]

Parts:
C12, C13, C14, C15: 100n X7R 16V; C_0603_1608Metric
U12, U13, U14, U15: 74LVC273PW,118; TSSOP-20_4.4x6.5mm_P0.65mm

Connections:
BG0: U13.2 (Q0)
BG1: U13.5 (Q1)
BG2: U13.6 (Q2)
CLK00: U12.11 (CP)
CLK1A: U14.11 (CP)
CLK05: U13.11 (CP)
CLK33: U15.11 (CP)
GND: C12.2, C13.2, C14.2, C15.2, U12.10 (GND), U12.14 (D5), U12.17 (D6), U13.10 (GND), U14.10 (GND), U15.10 (GND)
IN0: U12.2 (Q0)
IN1: U12.5 (Q1)
IN2: U12.6 (Q2)
IN3: U12.9 (Q3)
IN4: U12.12 (Q4)
IN7: U12.19 (Q7)
LV_D0: U12.3 (D0), U13.3 (D0), U14.3 (D0), U15.3 (D0)
LV_D1: U12.4 (D1), U13.4 (D1), U14.4 (D1), U15.4 (D1)
LV_D2: U12.7 (D2), U13.7 (D2), U14.7 (D2), U15.7 (D2)
LV_D3: U12.8 (D3), U13.8 (D3), U14.8 (D3), U15.8 (D3)
LV_D4: U13.13 (D4), U14.13 (D4), U15.13 (D4)
LV_D5: U13.14 (D5), U14.14 (D5), U15.14 (D5)
LV_D6: U13.17 (D6), U14.17 (D6), U15.17 (D6)
LV_D7: U12.18 (D7), U13.18 (D7), U14.18 (D7), U15.18 (D7)
M76: U14.16 (Q6)
M77: U14.19 (Q7)
REG_RESET_N: U12.1 (~MR), U13.1 (~MR), U14.1 (~MR), U15.1 (~MR)
SI0: U15.2 (Q0)
SI1: U15.5 (Q1)
SI2: U15.6 (Q2)
SI3: U15.9 (Q3)
SI6: U15.16 (Q6)
SI7: U15.19 (Q7)
V3V3: C12.1, C13.1, C14.1, C15.1, U12.13 (D4), U12.20 (VCC), U13.20 (VCC), U14.20 (VCC), U15.20 (VCC)

Notes on the sheet:
U12: D4 ist absichtlich HIGH (Write-valid), nicht INIDISP.D4. Vor dem ersten $2100-Write bleibt FORCE_BLANK aktiv. U15 liefert Interlace, Overscan, Pseudo-HiRes und EXTBG. Extra-Bits gehen an Diagnoseanschluss. Fuer Rastereffekte Registerzustand beim CAPTURE zuordnen, niemals live auf ein aelteres 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
