scenz-dev/superpico-digital/hardware/interface_v2/logic.kicad_sch

## KiCad design hardware/interface_v2/logic.kicad_sch (2026-11-12)

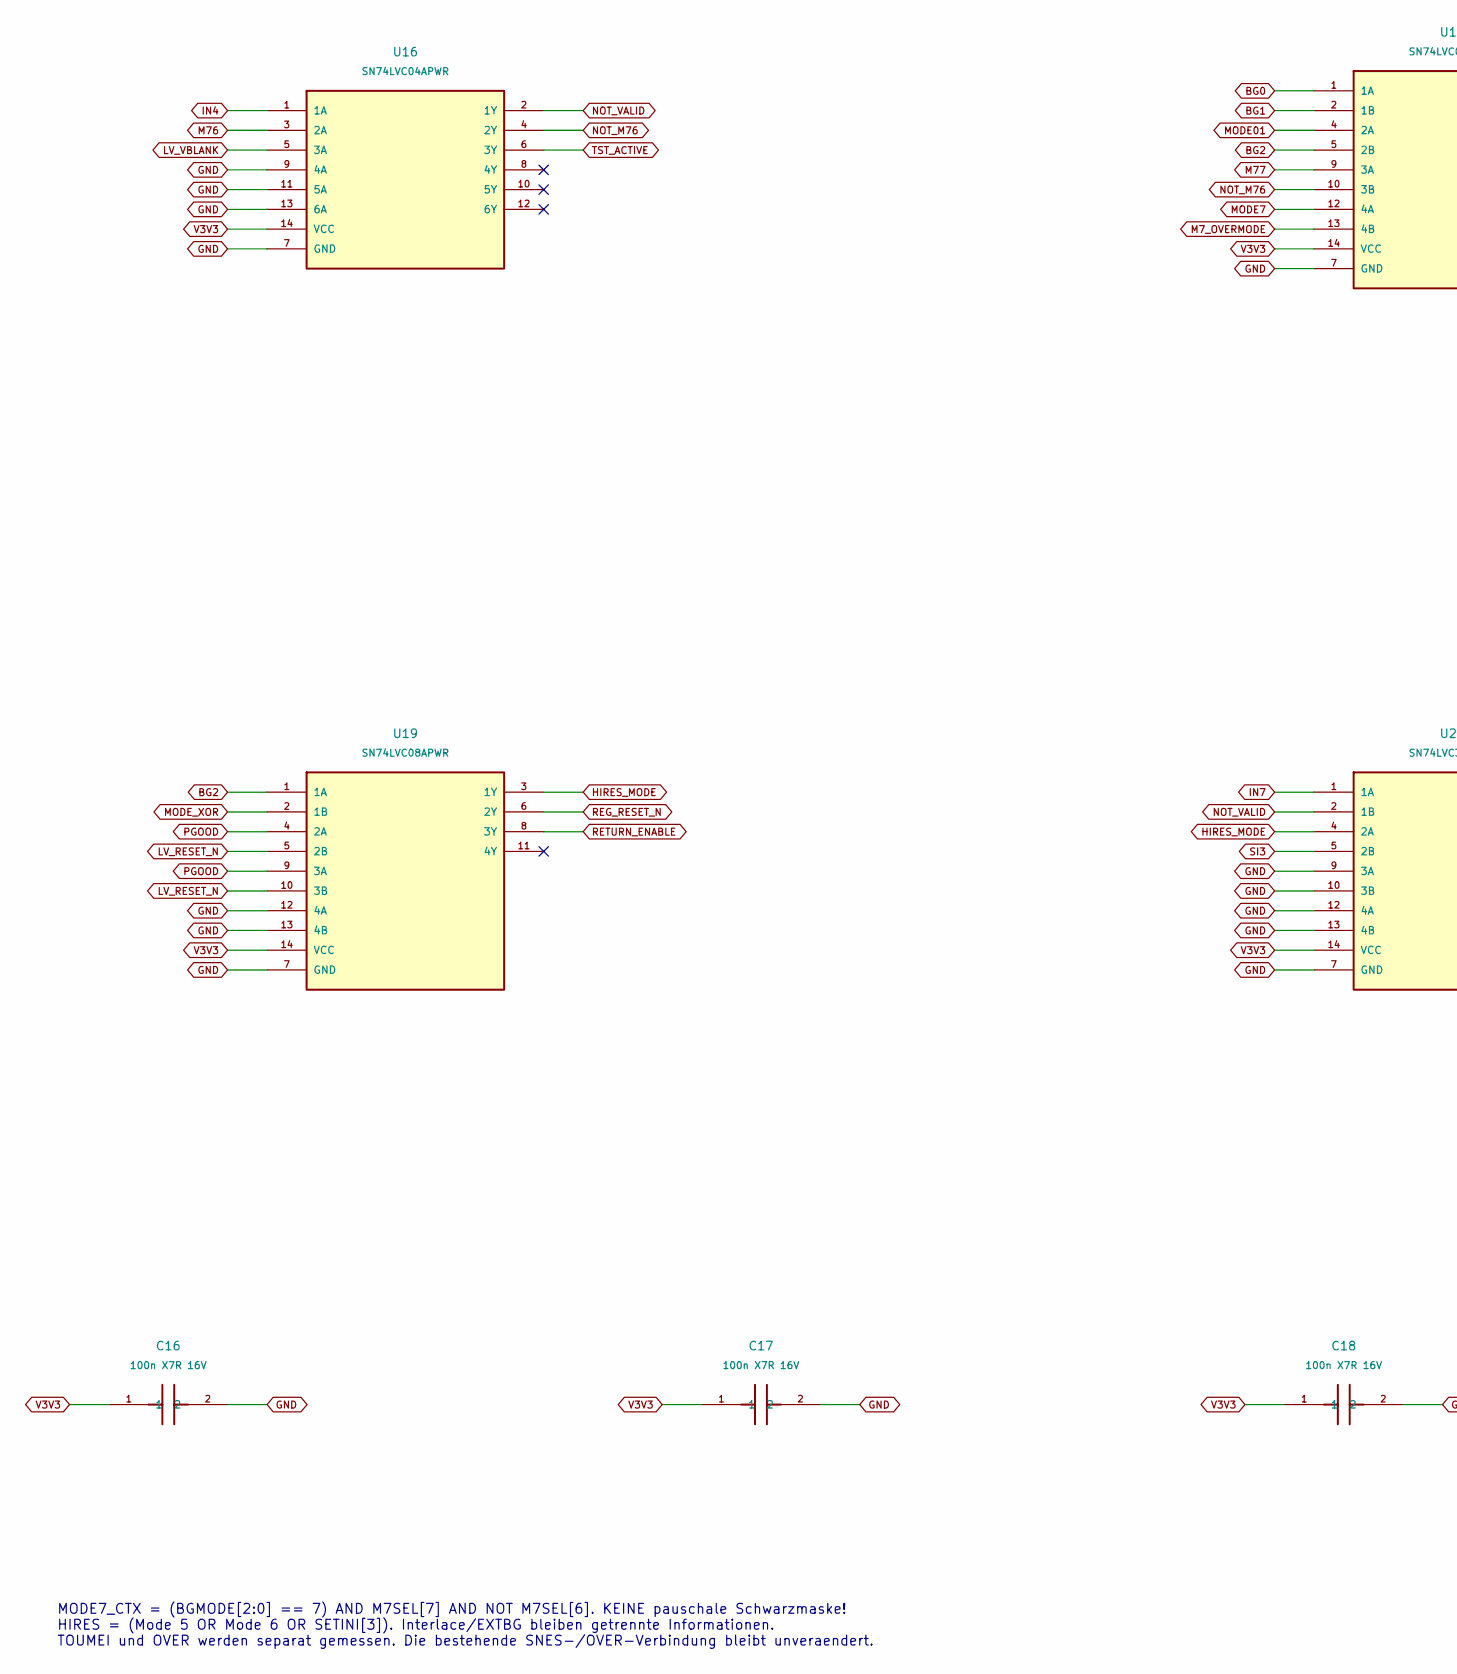
[picture p10: schematic logic.kicad_sch, part in row 1, column 1]

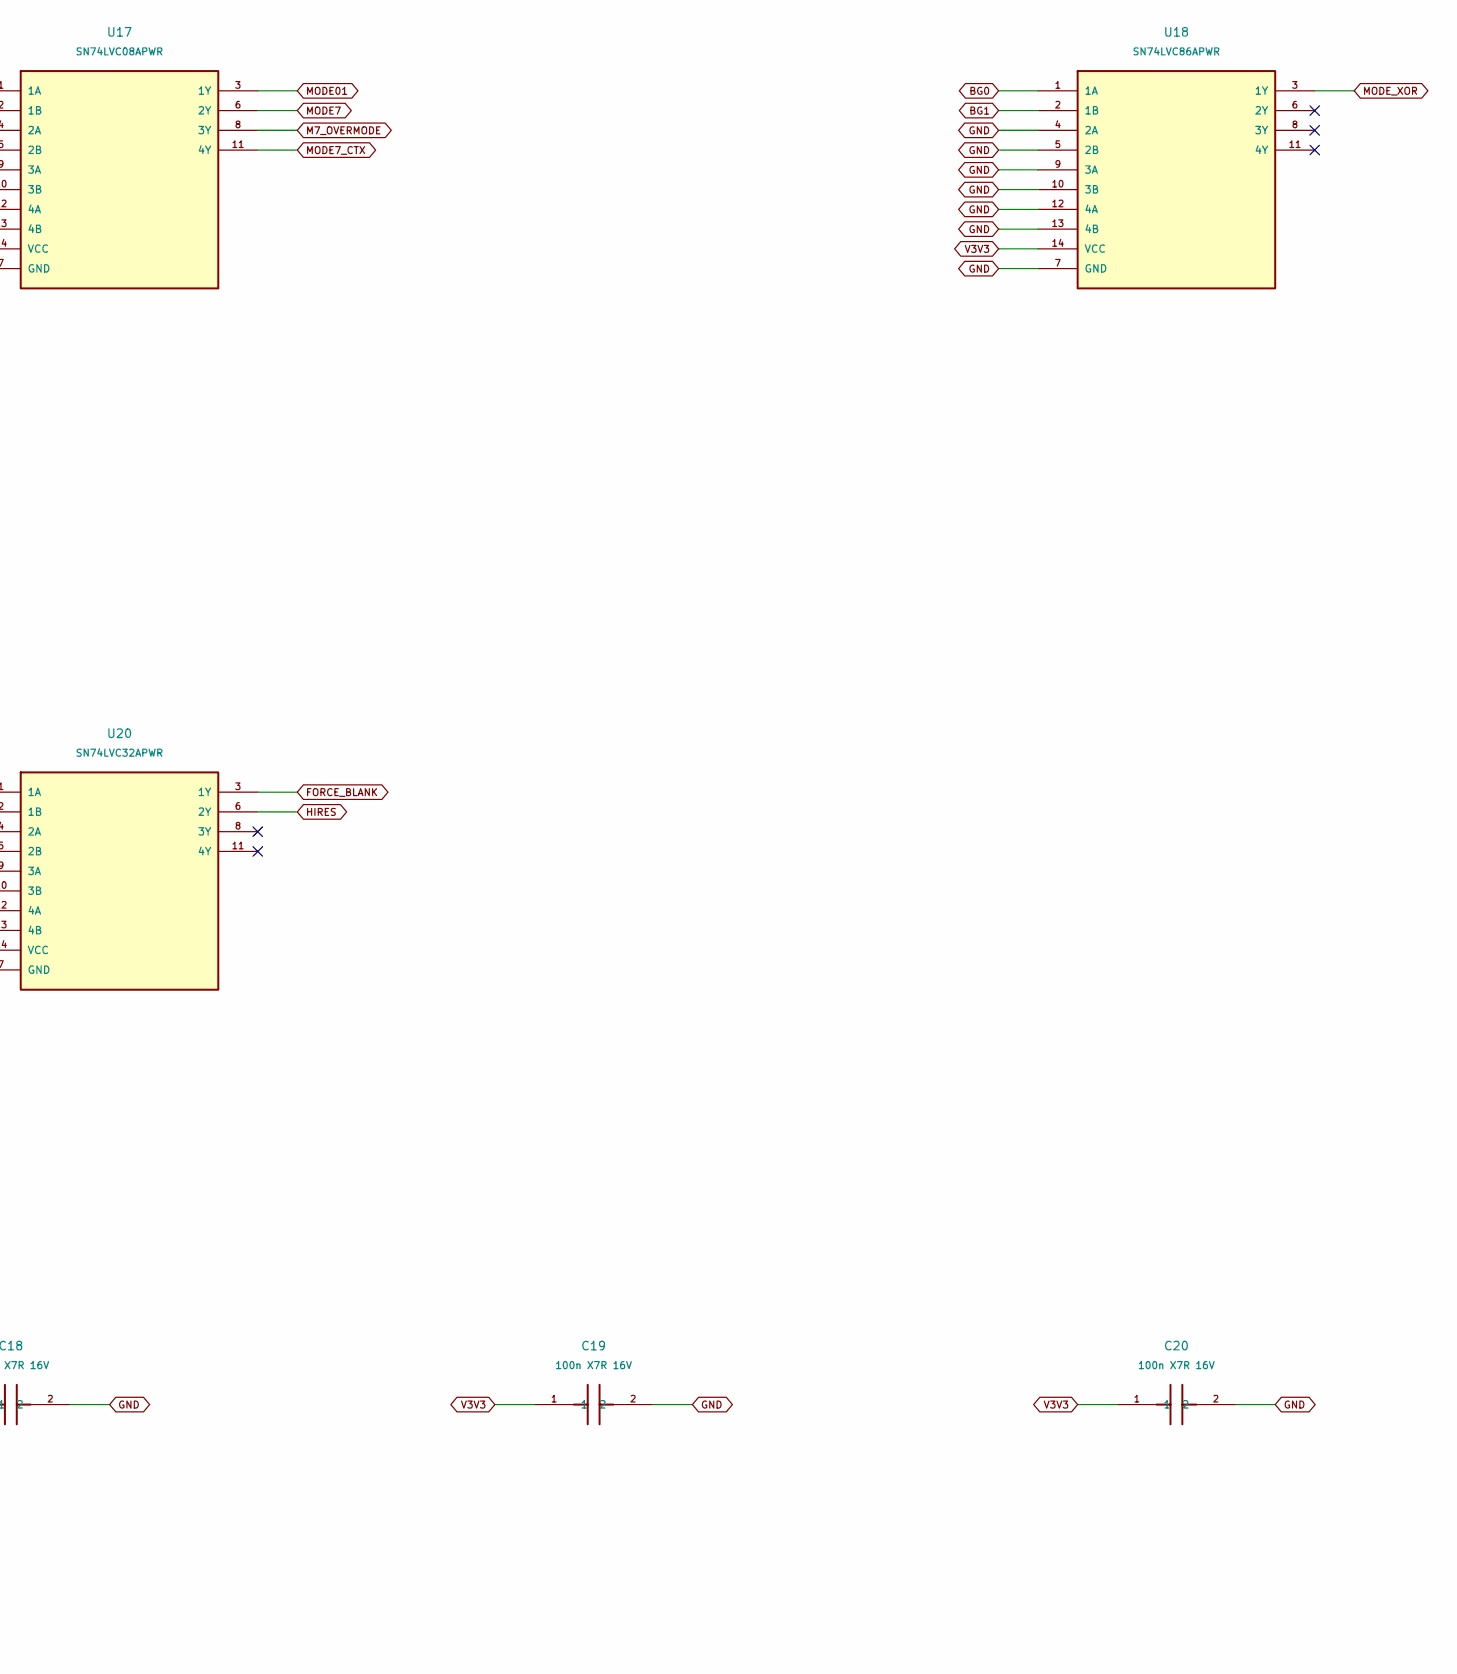
[picture p11: schematic logic.kicad_sch, part in row 1, column 2]

Parts:
C16, C17, C18, C19, C20: 100n X7R 16V; C_0603_1608Metric
U16: SN74LVC04APWR; TSSOP-14_4.4x5mm_P0.65mm
U17, U19: SN74LVC08APWR; TSSOP-14_4.4x5mm_P0.65mm
U18: SN74LVC86APWR; TSSOP-14_4.4x5mm_P0.65mm
U20: SN74LVC32APWR; TSSOP-14_4.4x5mm_P0.65mm

Connections:
BG0: U17.1 (1A), U18.1 (1A)
BG1: U17.2 (1B), U18.2 (1B)
BG2: U17.5 (2B), U19.1 (1A)
FORCE_BLANK: U20.3 (1Y)
GND: C16.2, C17.2, C18.2, C19.2, C20.2, U16.7 (GND), U16.9 (4A), U16.11 (5A), U16.13 (6A), U17.7 (GND), U18.4 (2A), U18.5 (2B), U18.7 (GND), U18.9 (3A), U18.10 (3B), U18.12 (4A), U18.13 (4B), U19.7 (GND), U19.12 (4A), U19.13 (4B), U20.7 (GND), U20.9 (3A), U20.10 (3B), U20.12 (4A), U20.13 (4B)
HIRES: U20.6 (2Y)
HIRES_MODE: U19.3 (1Y), U20.4 (2A)
IN4: U16.1 (1A)
IN7: U20.1 (1A)
LV_RESET_N: U19.5 (2B), U19.10 (3B)
LV_VBLANK: U16.5 (3A)
M7_OVERMODE: U17.8 (3Y), U17.13 (4B)
M76: U16.3 (2A)
M77: U17.9 (3A)
MODE01: U17.3 (1Y), U17.4 (2A)
MODE7: U17.6 (2Y), U17.12 (4A)
MODE7_CTX: U17.11 (4Y)
MODE_XOR: U18.3 (1Y), U19.2 (1B)
NOT_M76: U16.4 (2Y), U17.10 (3B)
NOT_VALID: U16.2 (1Y), U20.2 (1B)
PGOOD: U19.4 (2A), U19.9 (3A)
REG_RESET_N: U19.6 (2Y)
RETURN_ENABLE: U19.8 (3Y)
SI3: U20.5 (2B)
TST_ACTIVE: U16.6 (3Y)
V3V3: C16.1, C17.1, C18.1, C19.1, C20.1, U16.14 (VCC), U17.14 (VCC), U18.14 (VCC), U19.14 (VCC), U20.14 (VCC)

Notes on the sheet:
MODE7_CTX = (BGMODE[2:0] == 7) AND M7SEL[7] AND NOT M7SEL[6]. KEINE pauschale Schwarzmaske! HIRES = (Mode 5 OR Mode 6 OR SETINI[3]). Interlace/EXTBG bleiben getrennte Informationen. TOUMEI und OVER werden separat gemessen. Die bestehende SNES-/OVER-Verbindung bleibt unveraendert.
