scenz-dev/superpico-digital/hardware/interface_v2/pulls.kicad_sch

## KiCad design hardware/interface_v2/pulls.kicad_sch (2026-11-12)

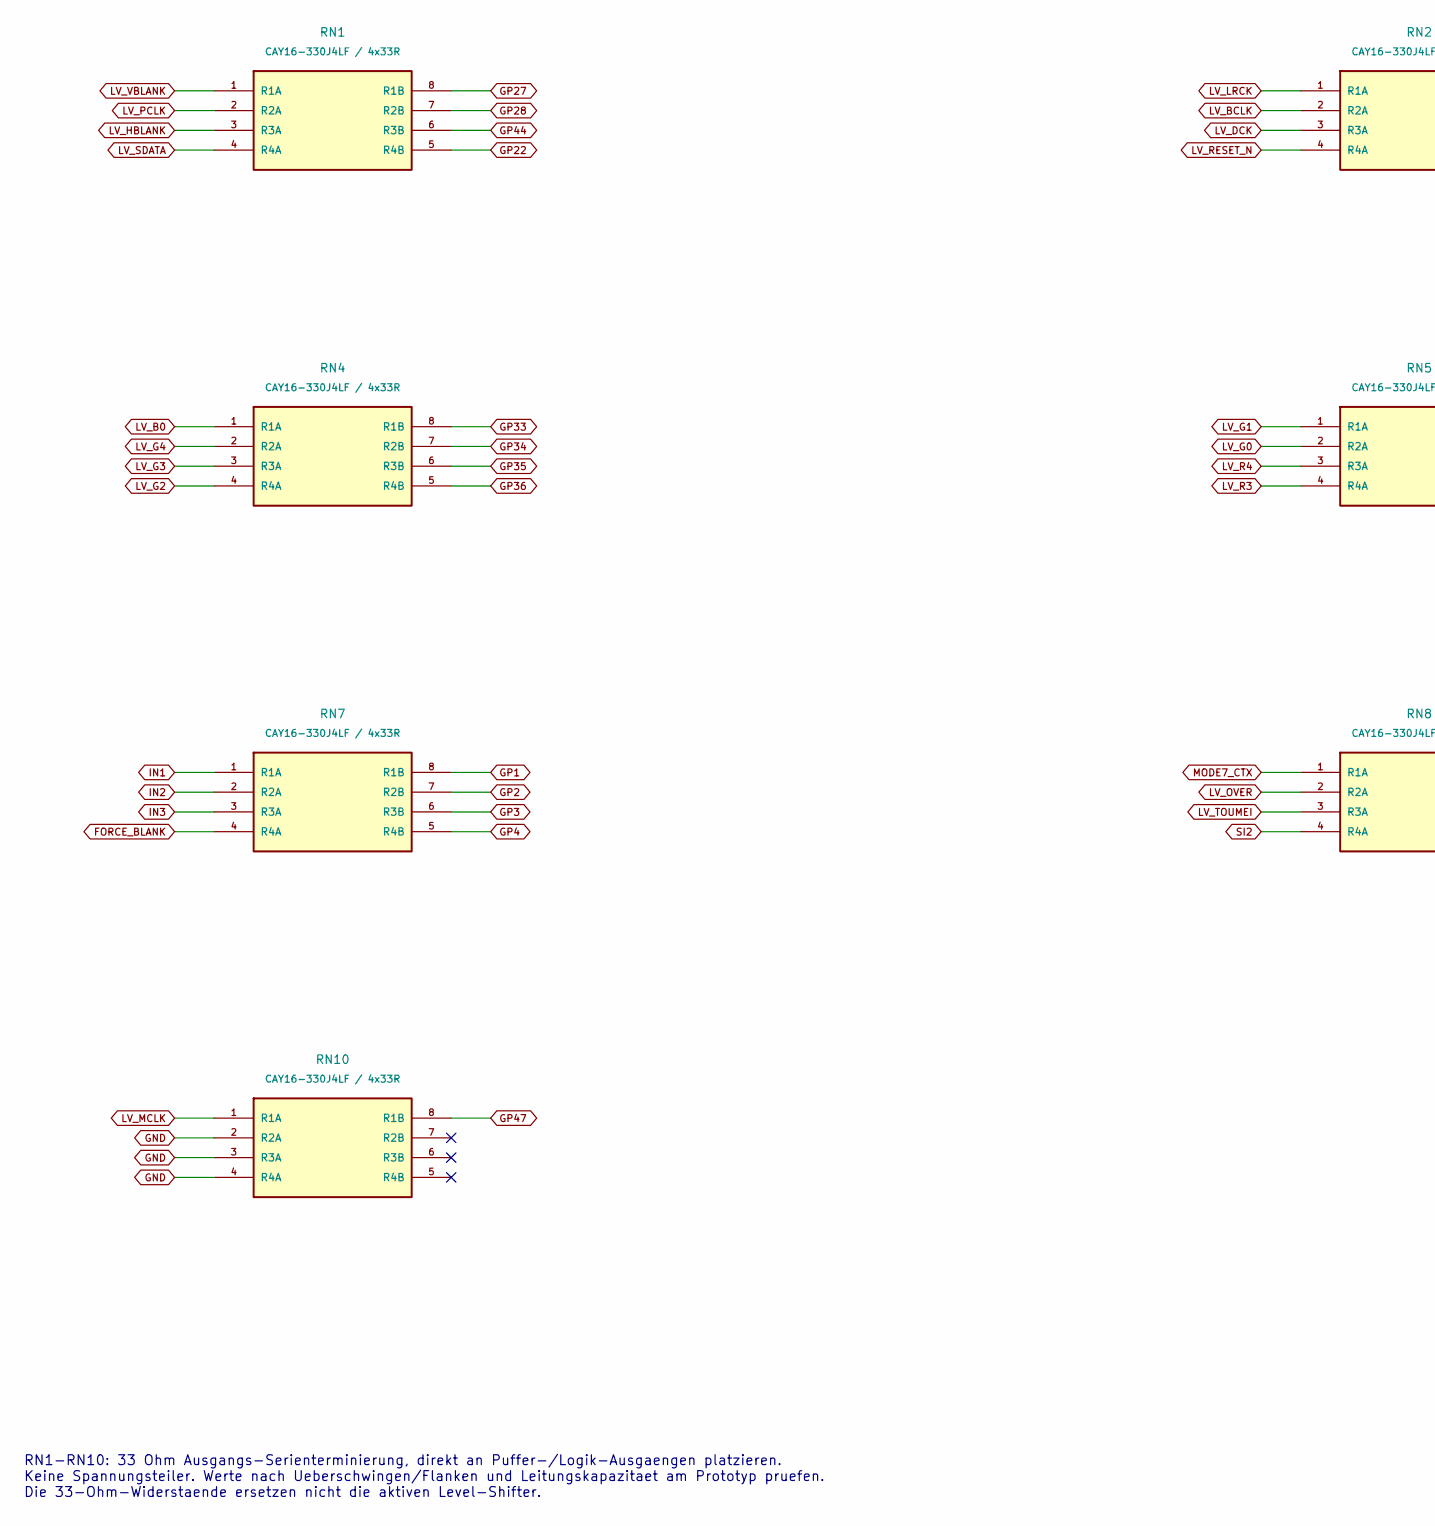
[picture p12: schematic pulls.kicad_sch, part in row 1, column 1]

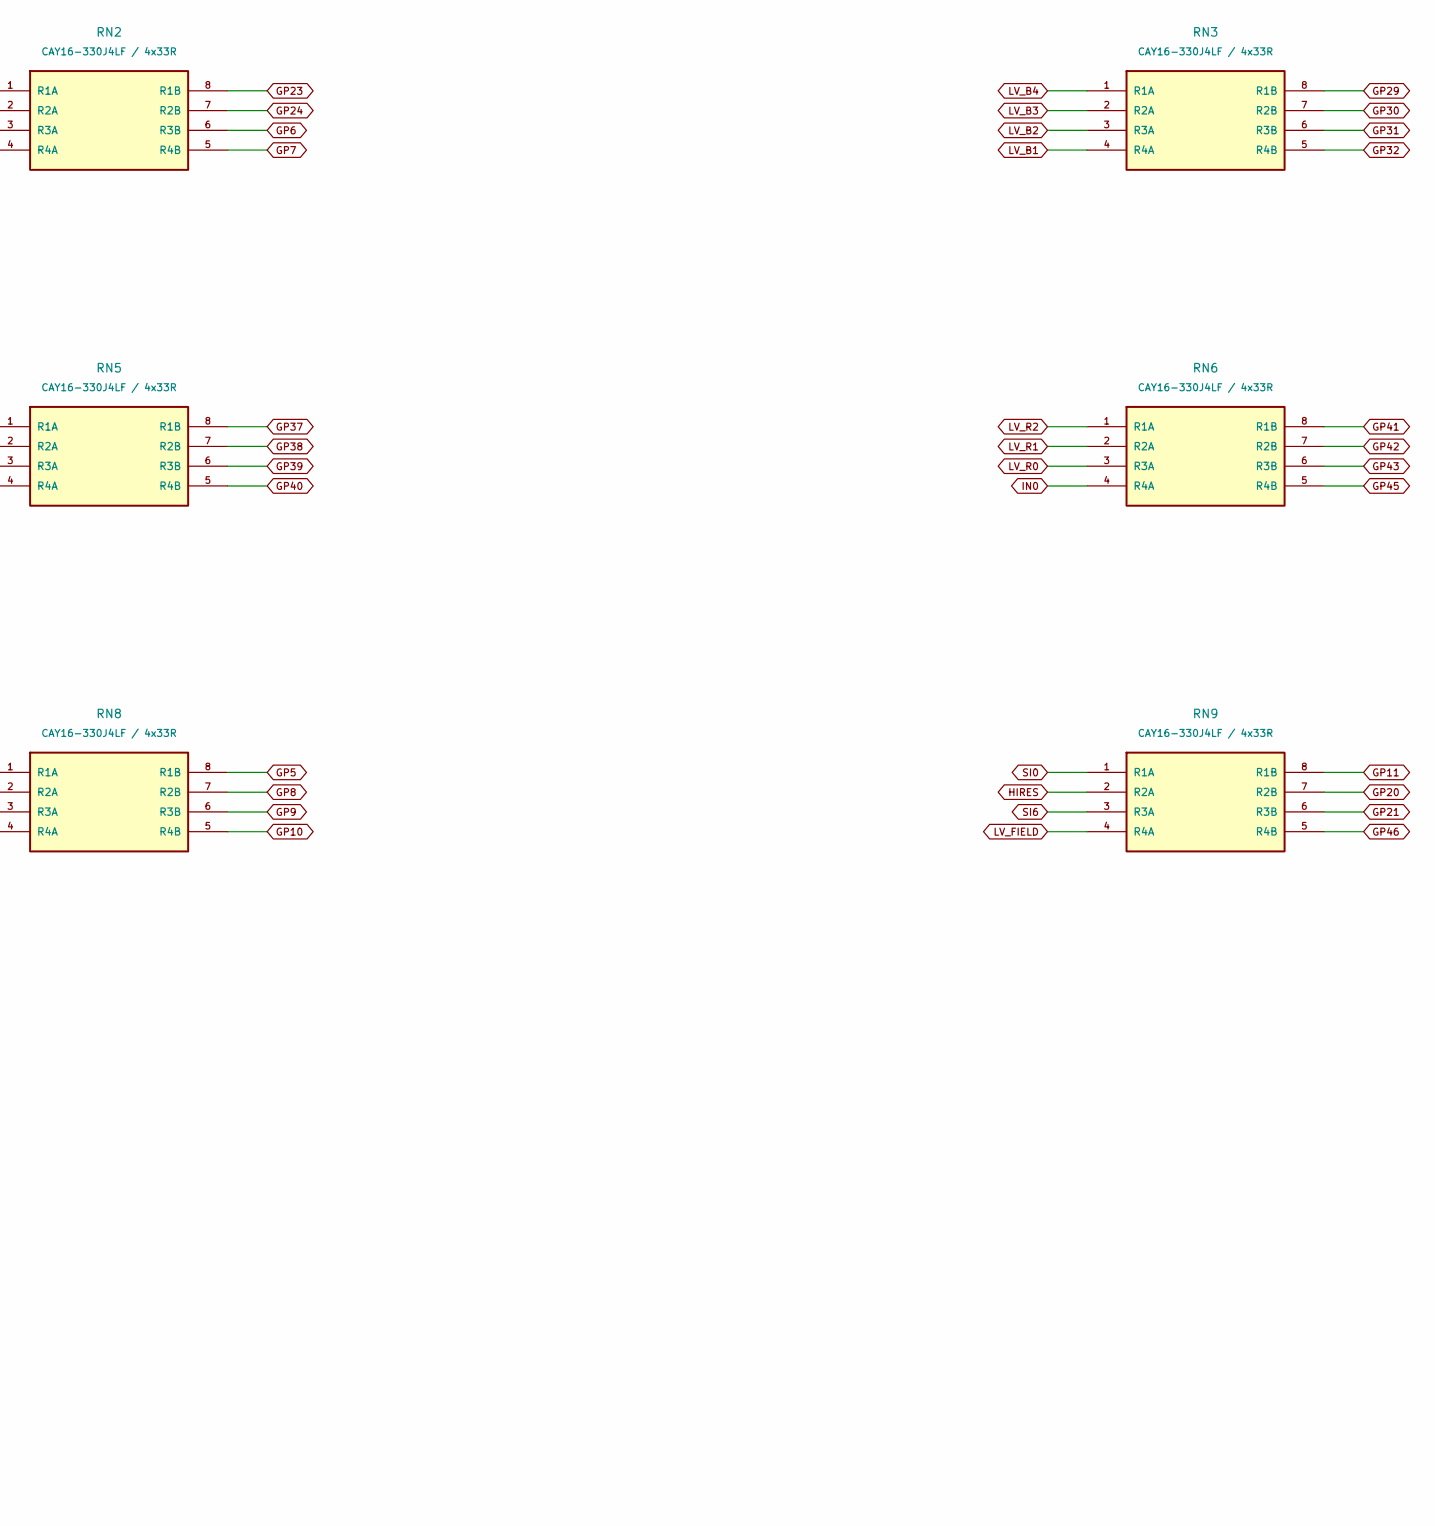
[picture p13: schematic pulls.kicad_sch, part in row 1, column 2]

Parts:
RN1, RN2, RN3, RN4, RN5, RN6, RN7, RN8, RN9, RN10: CAY16-330J4LF / 4x33R; R_Array_Convex_4x0603

Connections:
FORCE_BLANK: RN7.4 (R4A)
GND: RN10.2 (R2A), RN10.3 (R3A), RN10.4 (R4A)
GP1: RN7.8 (R1B)
GP2: RN7.7 (R2B)
GP3: RN7.6 (R3B)
GP4: RN7.5 (R4B)
GP5: RN8.8 (R1B)
GP6: RN2.6 (R3B)
GP7: RN2.5 (R4B)
GP8: RN8.7 (R2B)
GP9: RN8.6 (R3B)
GP10: RN8.5 (R4B)
GP11: RN9.8 (R1B)
GP20: RN9.7 (R2B)
GP21: RN9.6 (R3B)
GP22: RN1.5 (R4B)
GP23: RN2.8 (R1B)
GP24: RN2.7 (R2B)
GP27: RN1.8 (R1B)
GP28: RN1.7 (R2B)
GP29: RN3.8 (R1B)
GP30: RN3.7 (R2B)
GP31: RN3.6 (R3B)
GP32: RN3.5 (R4B)
GP33: RN4.8 (R1B)
GP34: RN4.7 (R2B)
GP35: RN4.6 (R3B)
GP36: RN4.5 (R4B)
GP37: RN5.8 (R1B)
GP38: RN5.7 (R2B)
GP39: RN5.6 (R3B)
GP40: RN5.5 (R4B)
GP41: RN6.8 (R1B)
GP42: RN6.7 (R2B)
GP43: RN6.6 (R3B)
GP44: RN1.6 (R3B)
GP45: RN6.5 (R4B)
GP46: RN9.5 (R4B)
GP47: RN10.8 (R1B)
HIRES: RN9.2 (R2A)
IN0: RN6.4 (R4A)
IN1: RN7.1 (R1A)
IN2: RN7.2 (R2A)
IN3: RN7.3 (R3A)
LV_B0: RN4.1 (R1A)
LV_B1: RN3.4 (R4A)
LV_B2: RN3.3 (R3A)
LV_B3: RN3.2 (R2A)
LV_B4: RN3.1 (R1A)
LV_BCLK: RN2.2 (R2A)
LV_DCK: RN2.3 (R3A)
LV_FIELD: RN9.4 (R4A)
LV_G0: RN5.2 (R2A)
LV_G1: RN5.1 (R1A)
LV_G2: RN4.4 (R4A)
LV_G3: RN4.3 (R3A)
LV_G4: RN4.2 (R2A)
LV_HBLANK: RN1.3 (R3A)
LV_LRCK: RN2.1 (R1A)
LV_MCLK: RN10.1 (R1A)
LV_OVER: RN8.2 (R2A)
LV_PCLK: RN1.2 (R2A)
LV_R0: RN6.3 (R3A)
LV_R1: RN6.2 (R2A)
LV_R2: RN6.1 (R1A)
LV_R3: RN5.4 (R4A)
LV_R4: RN5.3 (R3A)
LV_RESET_N: RN2.4 (R4A)
LV_SDATA: RN1.4 (R4A)
LV_TOUMEI: RN8.3 (R3A)
LV_VBLANK: RN1.1 (R1A)
MODE7_CTX: RN8.1 (R1A)
SI0: RN9.1 (R1A)
SI2: RN8.4 (R4A)
SI6: RN9.3 (R3A)

Notes on the sheet:
RN1-RN10: 33 Ohm Ausgangs-Serienterminierung, direkt an Puffer-/Logik-Ausgaengen platzieren. Keine Spannungsteiler. Werte nach Ueberschwingen/Flanken und Leitungskapazitaet am Prototyp pruefen. Die 33-Ohm-Widerstaende ersetzen nicht die aktiven Level-Shifter.
