scenz-dev/superpico-digital/hardware/interface_v2/return.kicad_sch

## KiCad design hardware/interface_v2/return.kicad_sch (2026-11-12)

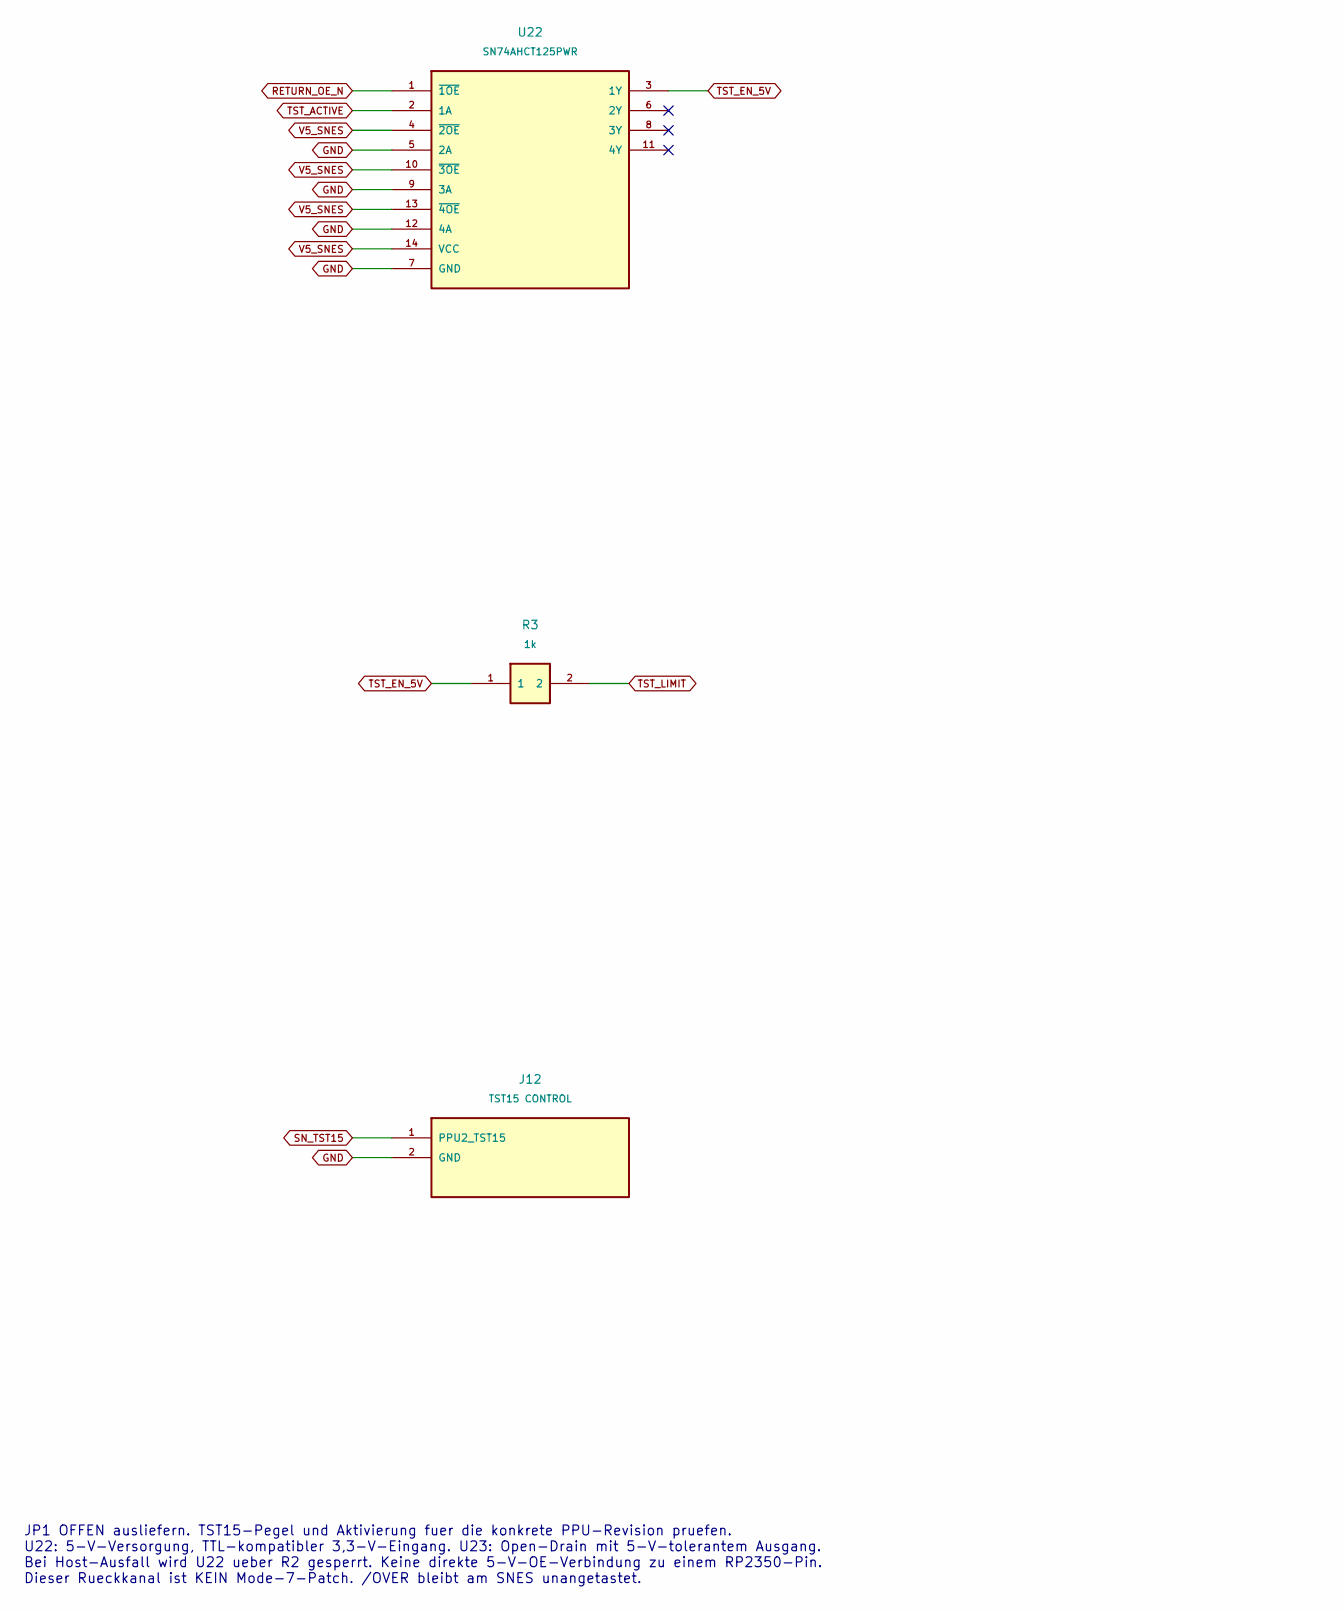
[picture p14: schematic return.kicad_sch, part in row 1, column 1]

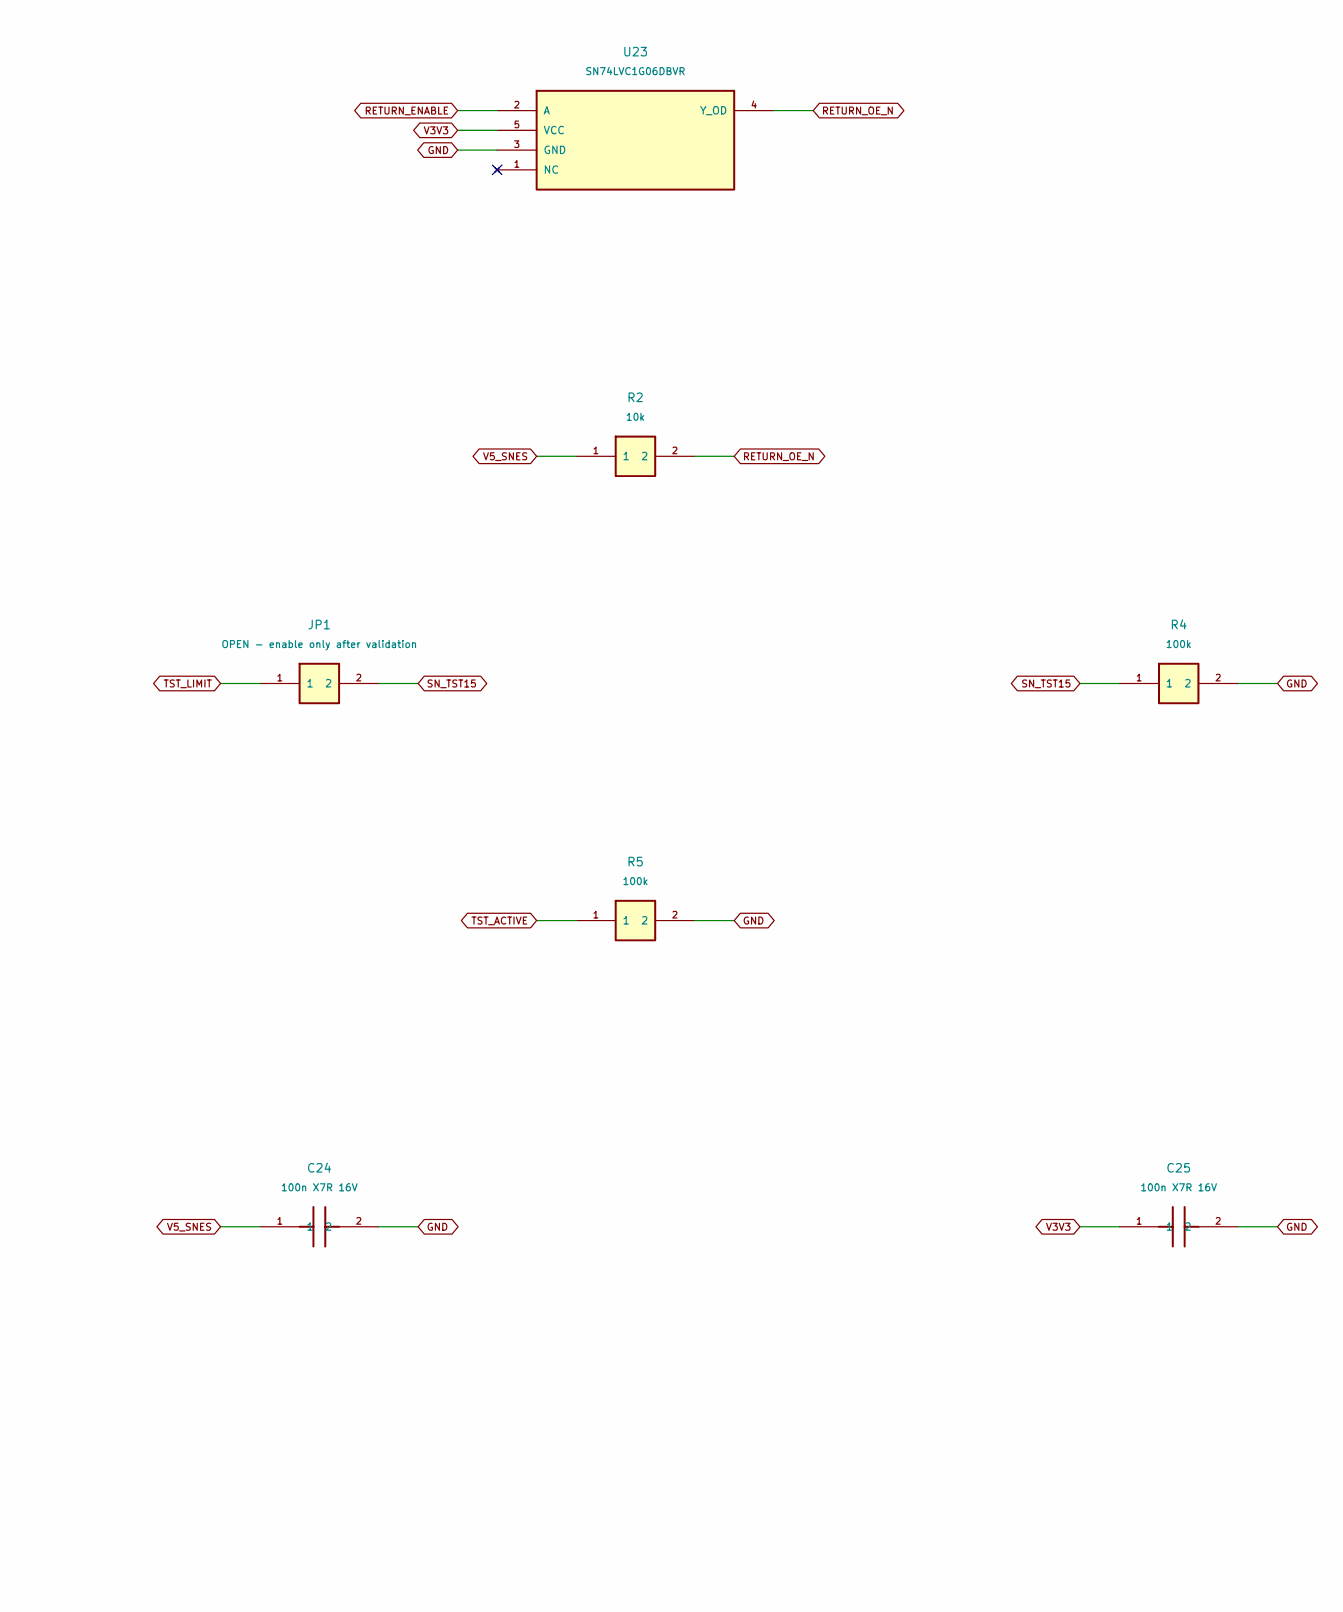
[picture p15: schematic return.kicad_sch, part in row 1, column 2]

Parts:
C24, C25: 100n X7R 16V; C_0603_1608Metric
J12: TST15 CONTROL; PinHeader_1x02_P2.54mm_Vertical
JP1: OPEN - enable only after validation; SolderJumper-2_P1.3mm_Open_Pad1.0x1.5mm
R2: 10k; R_0603_1608Metric
R3: 1k; R_0603_1608Metric
R4, R5: 100k; R_0603_1608Metric
U22: SN74AHCT125PWR; TSSOP-14_4.4x5mm_P0.65mm
U23: SN74LVC1G06DBVR; SOT-23-5

Connections:
GND: C24.2, C25.2, J12.2 (GND), R4.2, R5.2, U22.5 (2A), U22.7 (GND), U22.9 (3A), U22.12 (4A), U23.3 (GND)
RETURN_ENABLE: U23.2 (A)
RETURN_OE_N: R2.2, U22.1 (~1OE), U23.4 (Y_OD)
SN_TST15: J12.1 (PPU2_TST15), JP1.2, R4.1
TST_ACTIVE: R5.1, U22.2 (1A)
TST_EN_5V: R3.1, U22.3 (1Y)
TST_LIMIT: JP1.1, R3.2
V3V3: C25.1, U23.5 (VCC)
V5_SNES: C24.1, R2.1, U22.4 (~2OE), U22.10 (~3OE), U22.13 (~4OE), U22.14 (VCC)

Notes on the sheet:
JP1 OFFEN ausliefern. TST15-Pegel und Aktivierung fuer die konkrete PPU-Revision pruefen. U22: 5-V-Versorgung, TTL-kompatibler 3,3-V-Eingang. U23: Open-Drain mit 5-V-tolerantem Ausgang. Bei Host-Ausfall wird U22 ueber R2 gesperrt. Keine direkte 5-V-OE-Verbindung zu einem RP2350-Pin. Dieser Rueckkan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
