scenz-dev/superpico-digital/hardware/interface_v2/superpico_interface_v2.kicad_sch

## KiCad design hardware/interface_v2/superpico_interface_v2.kicad_sch (2026-11-12)

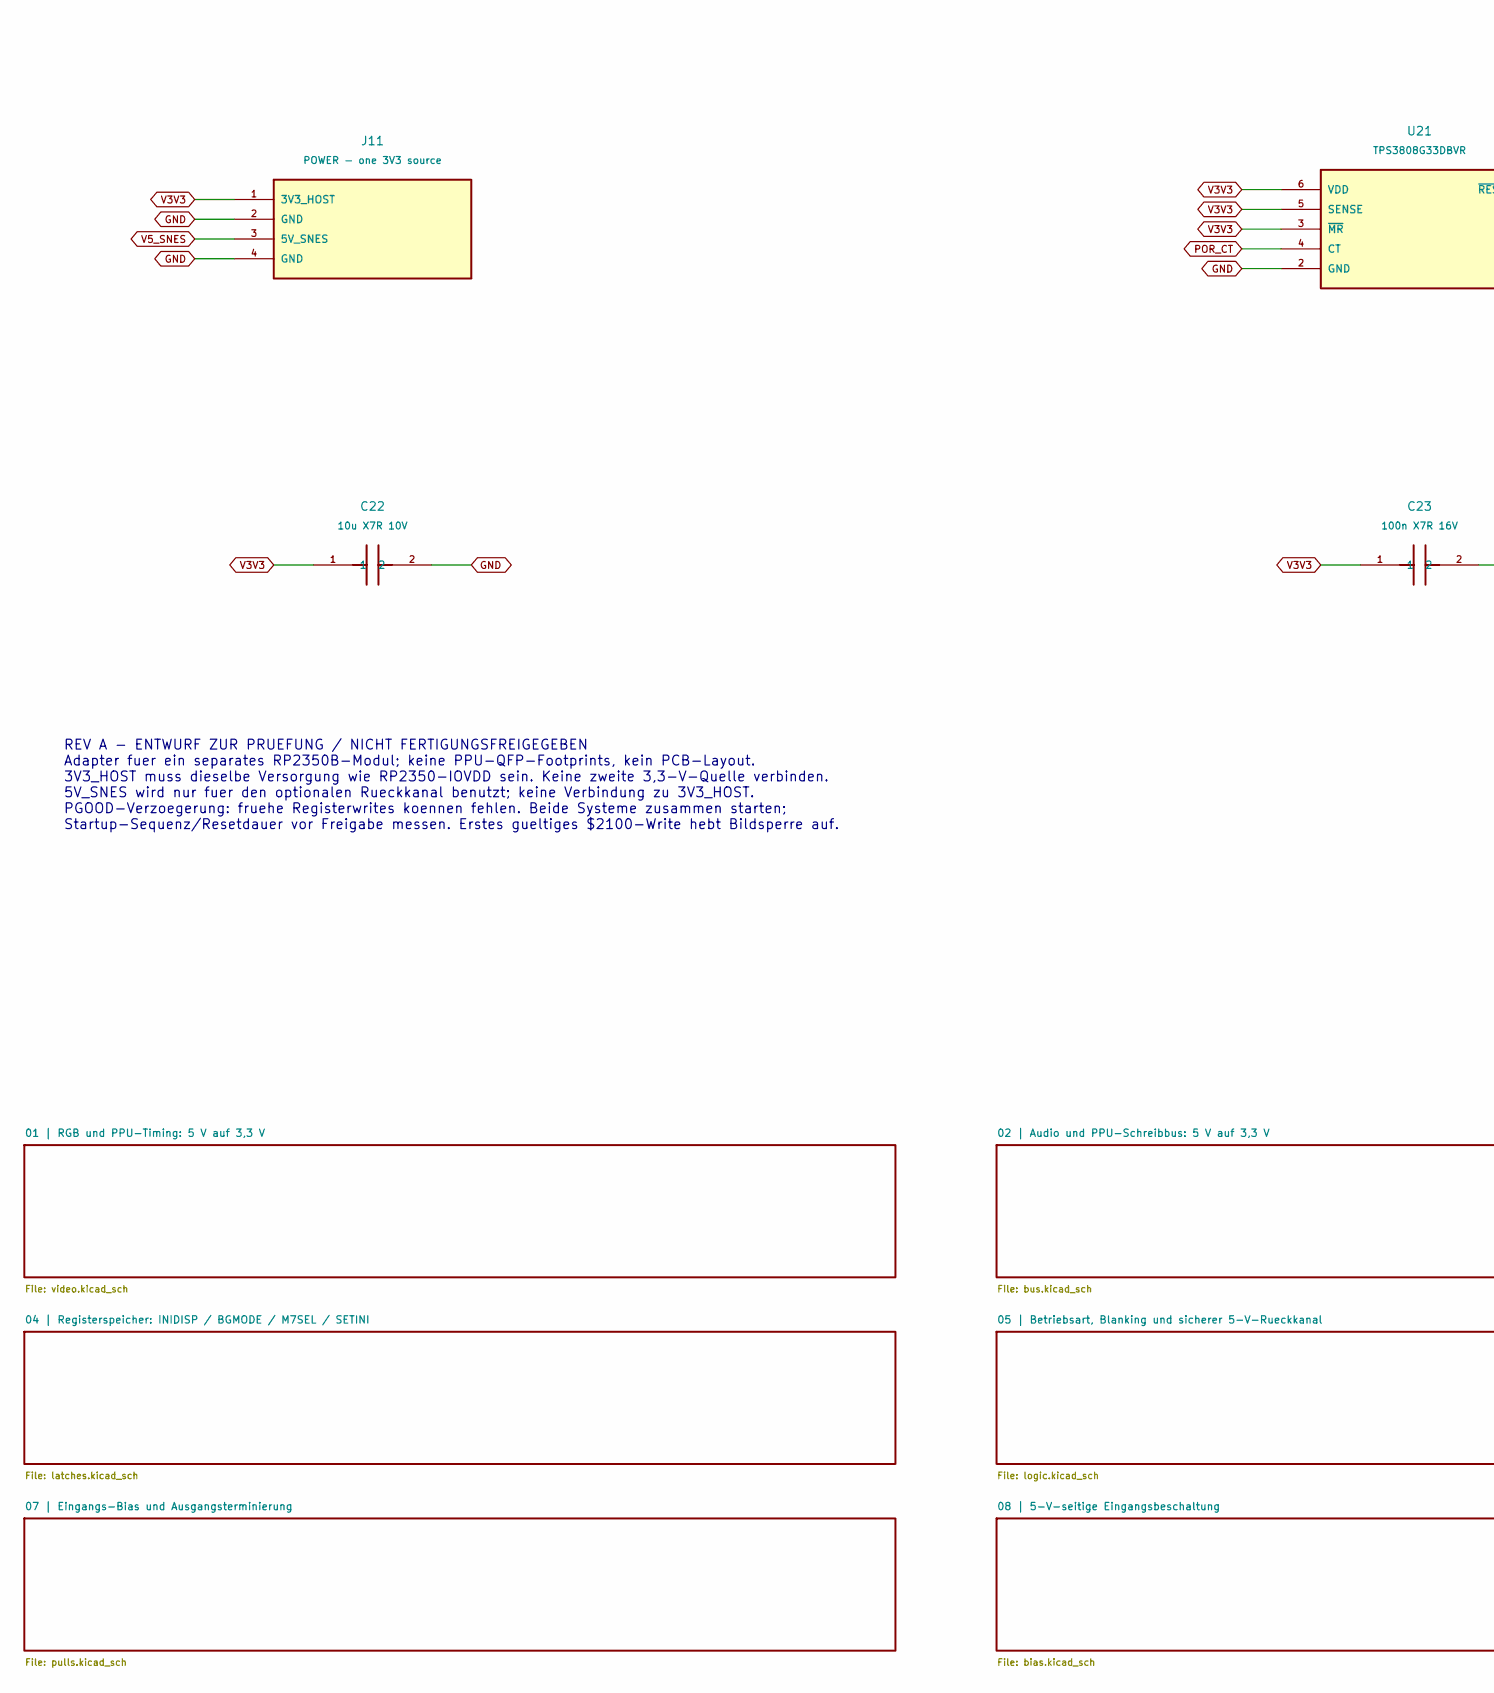
[picture p16: schematic superpico_interface_v2.kicad_sch, part in row 1, column 1]

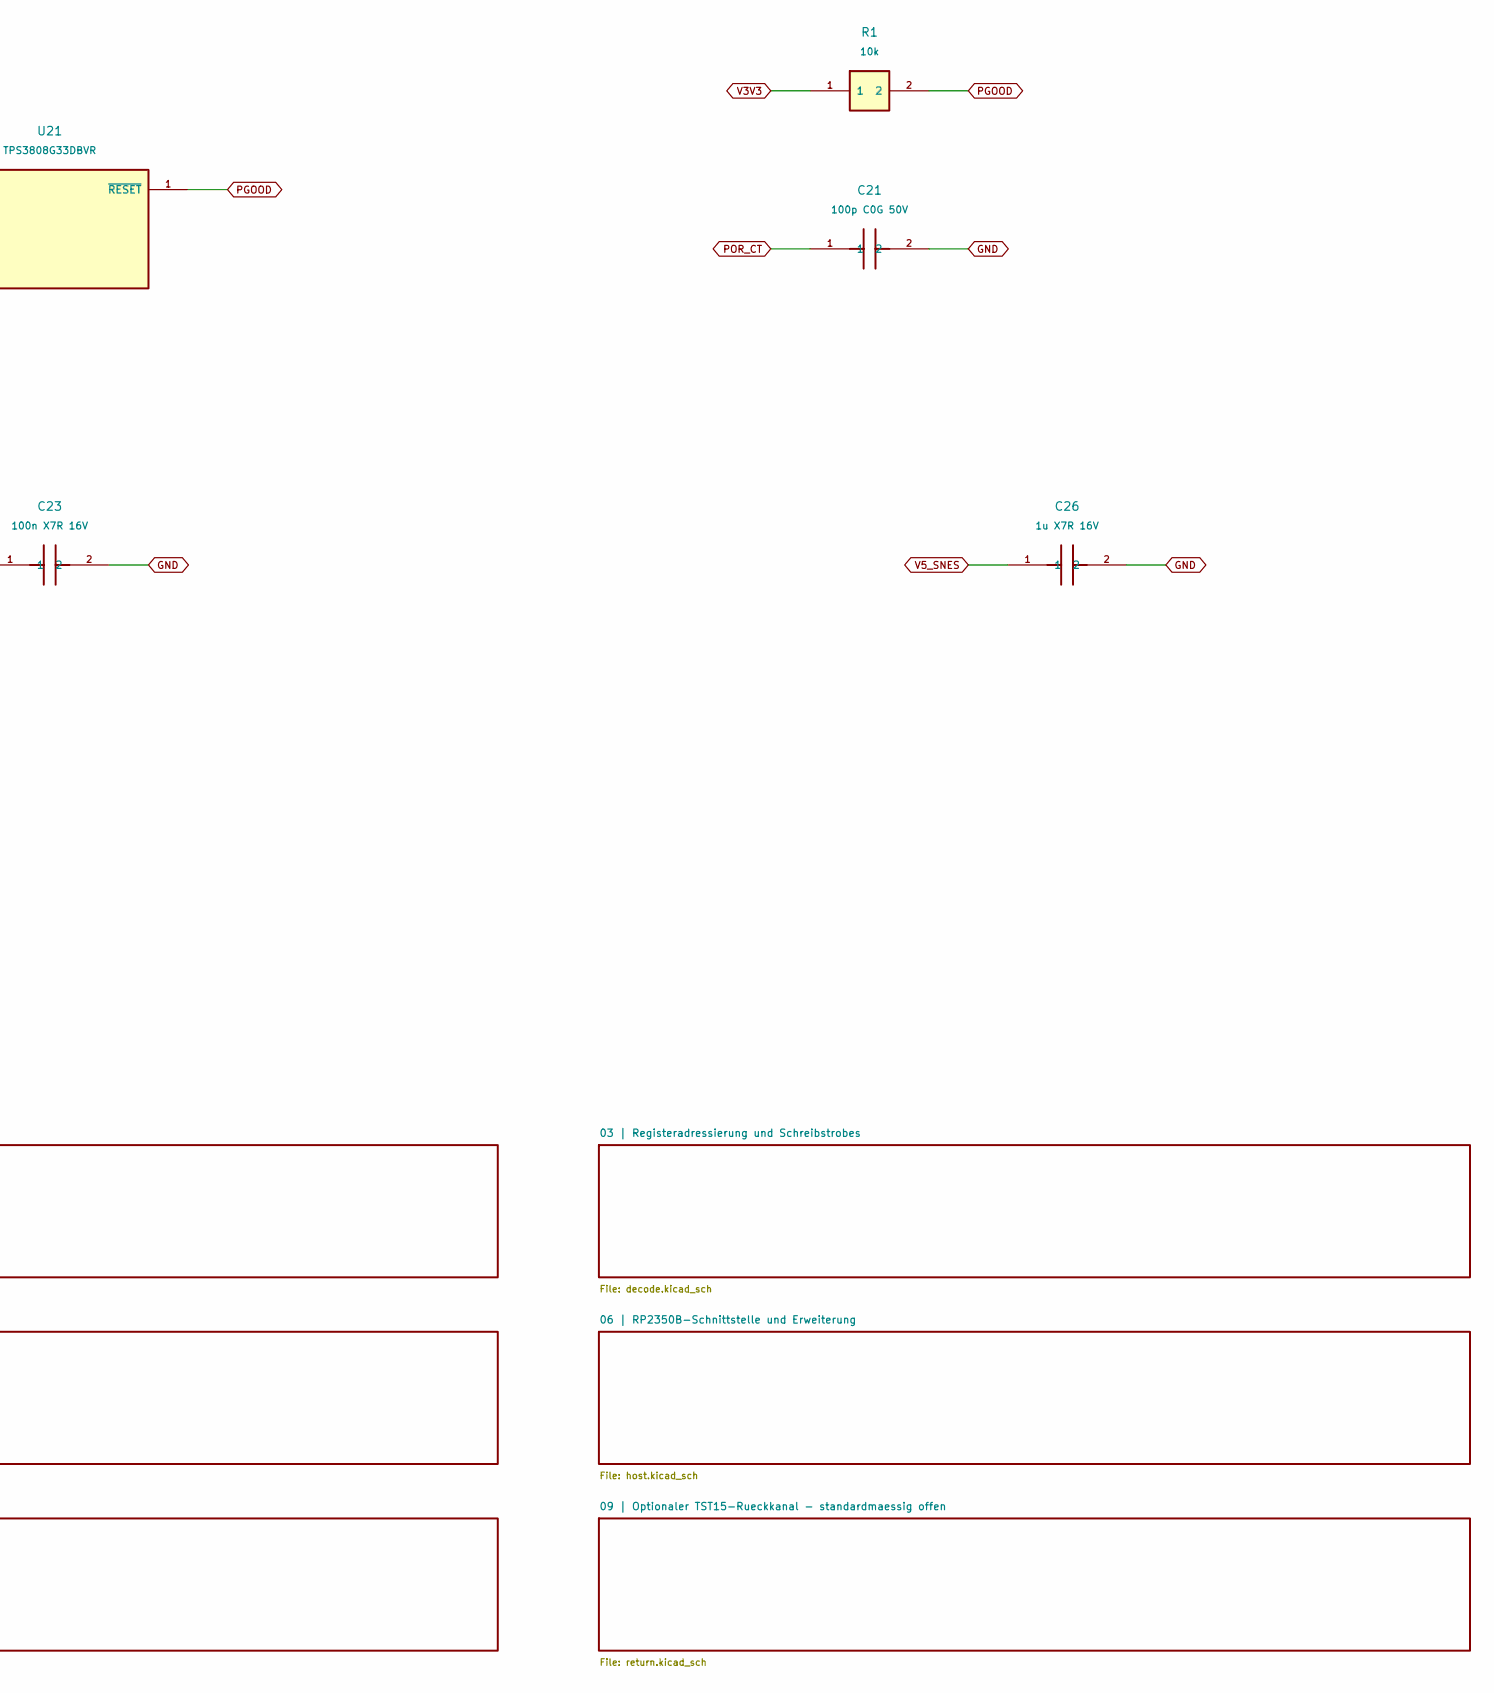
[picture p17: schematic superpico_interface_v2.kicad_sch, part in row 1, column 2]

Parts:
C21: 100p C0G 50V; C_0603_1608Metric
C22: 10u X7R 10V; C_0603_1608Metric
C23: 100n X7R 16V; C_0603_1608Metric
C26: 1u X7R 16V; C_0603_1608Metric
J11: POWER - one 3V3 source; PinHeader_1x04_P2.54mm_Vertical
R1: 10k; R_0603_1608Metric
U21: TPS3808G33DBVR; SOT-23-6

Connections:
GND: C21.2, C22.2, C23.2, C26.2, J11.2 (GND), J11.4 (GND), U21.2 (GND)
PGOOD: R1.2, U21.1 (~RESET)
POR_CT: C21.1, U21.4 (CT)
V3V3: C22.1, C23.1, J11.1 (3V3_HOST), R1.1, U21.3 (~MR), U21.5 (SENSE), U21.6 (VDD)
V5_SNES: C26.1, J11.3 (5V_SNES)

Notes on the sheet:
REV A - ENTWURF ZUR PRUEFUNG / NICHT FERTIGUNGSFREIGEGEBEN Adapter fuer ein separates RP2350B-Modul; keine PPU-QFP-Footprints, kein PCB-Layout. 3V3_HOST muss dieselbe Versorgung wie RP2350-IOVDD sein. Keine zweite 3,3-V-Quelle verbinden. 5V_SNES wird nur fuer den optionalen Rueckkanal benutzt; kein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
