scenz-dev/superpico-digital/hardware/interface_v2/video.kicad_sch

## KiCad design hardware/interface_v2/video.kicad_sch (2026-11-12)

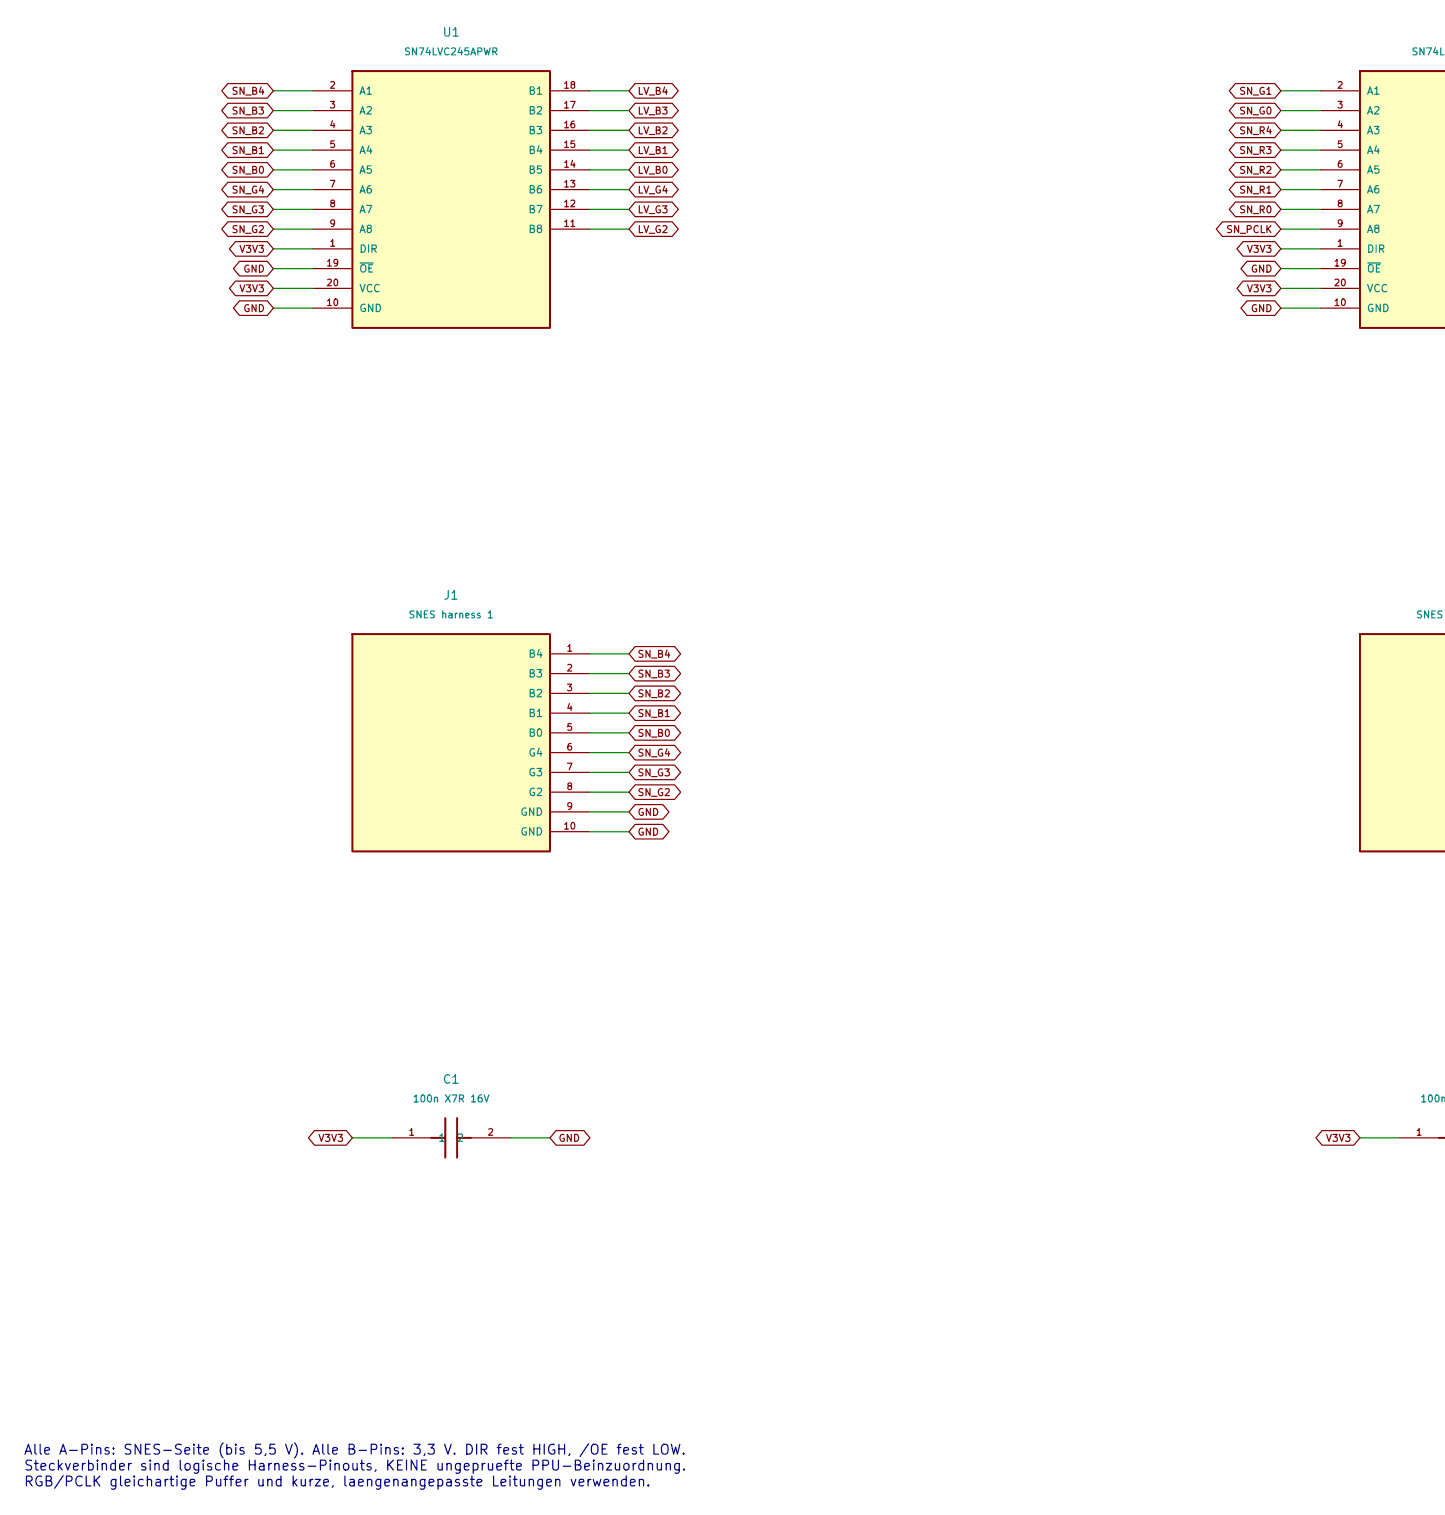
[picture p18: schematic video.kicad_sch, part in row 1, column 1]

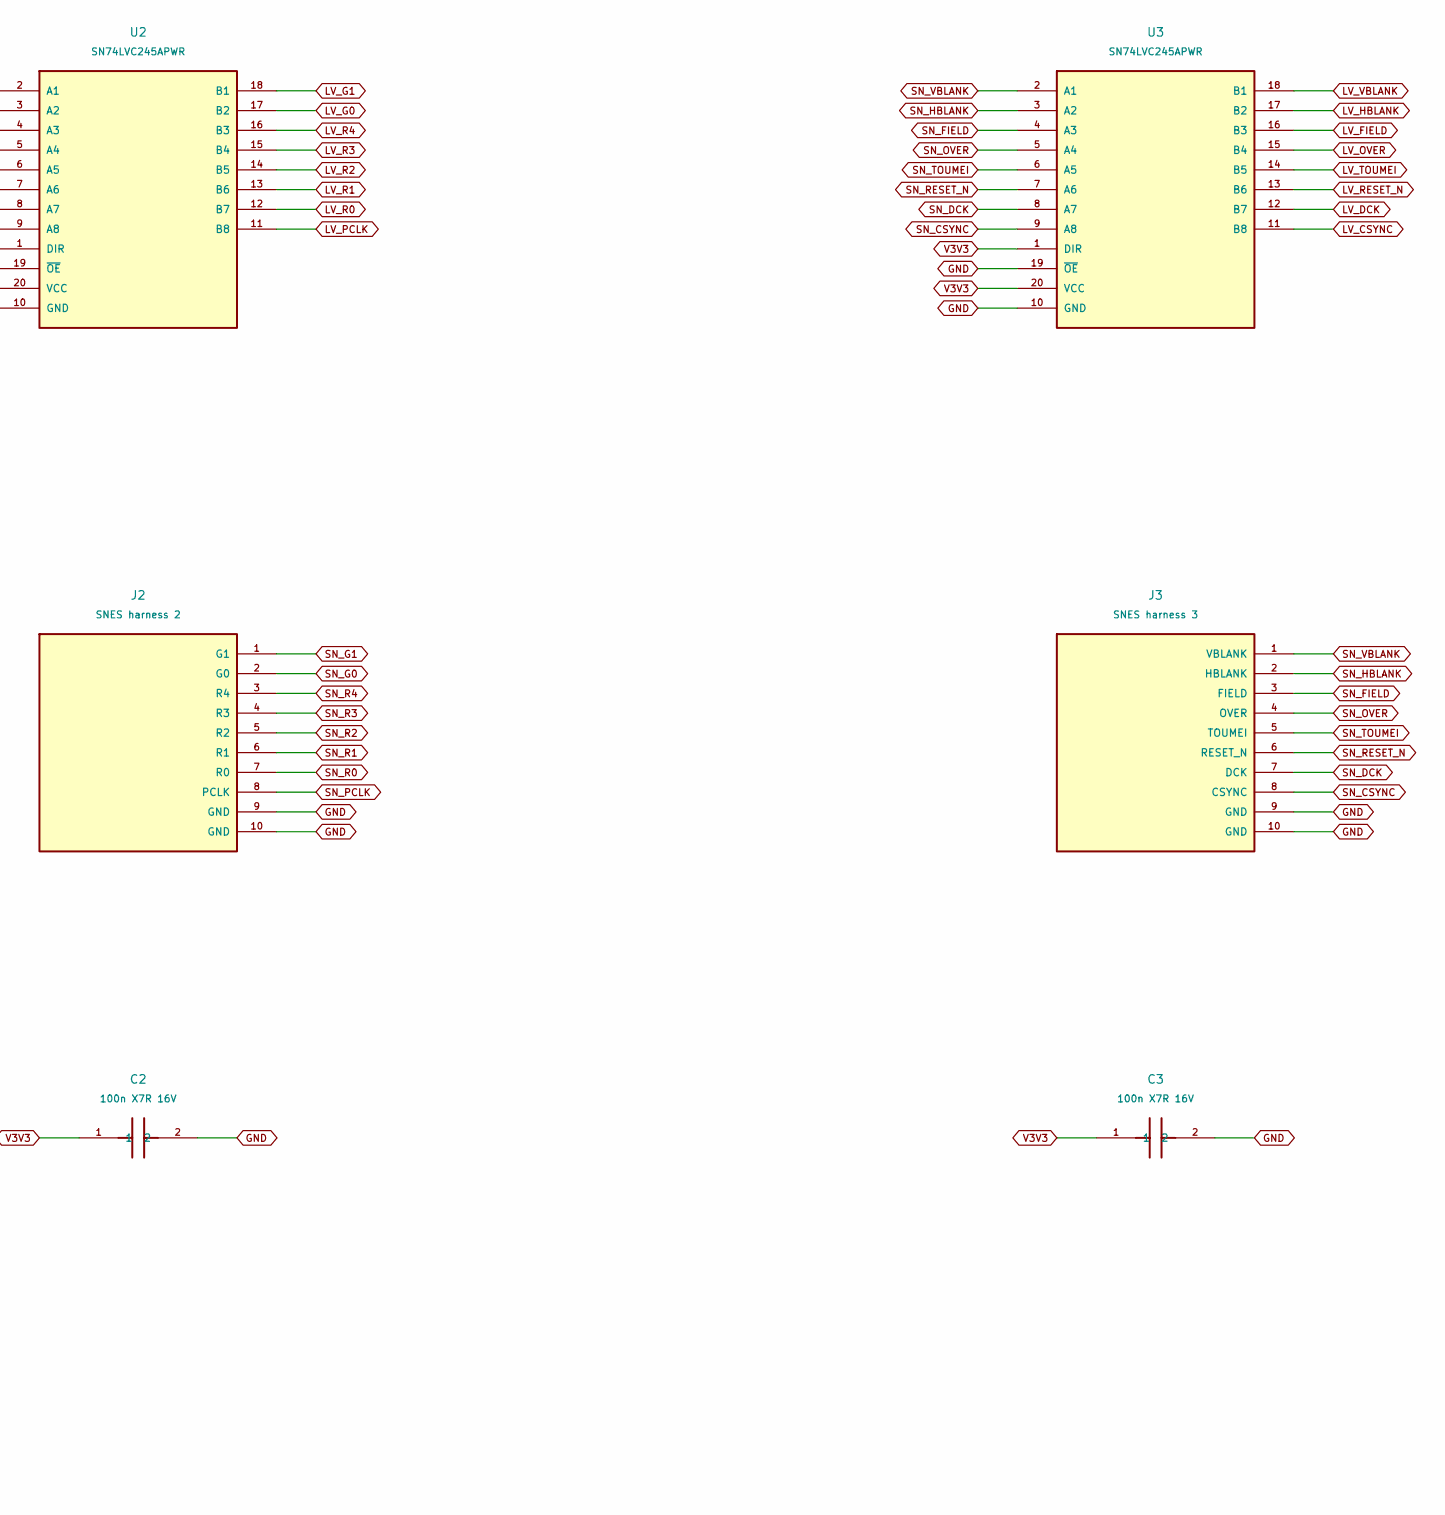
[picture p19: schematic video.kicad_sch, part in row 1, column 2]

Parts:
C1, C2, C3: 100n X7R 16V; C_0603_1608Metric
J1: SNES harness 1; PinHeader_2x05_P2.54mm_Vertical
J2: SNES harness 2; PinHeader_2x05_P2.54mm_Vertical
J3: SNES harness 3; PinHeader_2x05_P2.54mm_Vertical
U1, U2, U3: SN74LVC245APWR; TSSOP-20_4.4x6.5mm_P0.65mm

Connections:
GND: C1.2, C2.2, C3.2, J1.9 (GND), J1.10 (GND), J2.9 (GND), J2.10 (GND), J3.9 (GND), J3.10 (GND), U1.10 (GND), U1.19 (~OE), U2.10 (GND), U2.19 (~OE), U3.10 (GND), U3.19 (~OE)
LV_B0: U1.14 (B5)
LV_B1: U1.15 (B4)
LV_B2: U1.16 (B3)
LV_B3: U1.17 (B2)
LV_B4: U1.18 (B1)
LV_CSYNC: U3.11 (B8)
LV_DCK: U3.12 (B7)
LV_FIELD: U3.16 (B3)
LV_G0: U2.17 (B2)
LV_G1: U2.18 (B1)
LV_G2: U1.11 (B8)
LV_G3: U1.12 (B7)
LV_G4: U1.13 (B6)
LV_HBLANK: U3.17 (B2)
LV_OVER: U3.15 (B4)
LV_PCLK: U2.11 (B8)
LV_R0: U2.12 (B7)
LV_R1: U2.13 (B6)
LV_R2: U2.14 (B5)
LV_R3: U2.15 (B4)
LV_R4: U2.16 (B3)
LV_RESET_N: U3.13 (B6)
LV_TOUMEI: U3.14 (B5)
LV_VBLANK: U3.18 (B1)
SN_B0: J1.5 (B0), U1.6 (A5)
SN_B1: J1.4 (B1), U1.5 (A4)
SN_B2: J1.3 (B2), U1.4 (A3)
SN_B3: J1.2 (B3), U1.3 (A2)
SN_B4: J1.1 (B4), U1.2 (A1)
SN_CSYNC: J3.8 (CSYNC), U3.9 (A8)
SN_DCK: J3.7 (DCK), U3.8 (A7)
SN_FIELD: J3.3 (FIELD), U3.4 (A3)
SN_G0: J2.2 (G0), U2.3 (A2)
SN_G1: J2.1 (G1), U2.2 (A1)
SN_G2: J1.8 (G2), U1.9 (A8)
SN_G3: J1.7 (G3), U1.8 (A7)
SN_G4: J1.6 (G4), U1.7 (A6)
SN_HBLANK: J3.2 (HBLANK), U3.3 (A2)
SN_OVER: J3.4 (OVER), U3.5 (A4)
SN_PCLK: J2.8 (PCLK), U2.9 (A8)
SN_R0: J2.7 (R0), U2.8 (A7)
SN_R1: J2.6 (R1), U2.7 (A6)
SN_R2: J2.5 (R2), U2.6 (A5)
SN_R3: J2.4 (R3), U2.5 (A4)
SN_R4: J2.3 (R4), U2.4 (A3)
SN_RESET_N: J3.6 (RESET_N), U3.7 (A6)
SN_TOUMEI: J3.5 (TOUMEI), U3.6 (A5)
SN_VBLANK: J3.1 (VBLANK), U3.2 (A1)
V3V3: C1.1, C2.1, C3.1, U1.1 (DIR), U1.20 (VCC), U2.1 (DIR), U2.20 (VCC), U3.1 (DIR), U3.20 (VCC)

Notes on the sheet:
Alle A-Pins: SNES-Seite (bis 5,5 V). Alle B-Pins: 3,3 V. DIR fest HIGH, /OE fest LOW. Steckverbinder sind logische Harness-Pinouts, KEINE ungepruefte PPU-Beinzuordnung. RGB/PCLK gleichartige Puffer und kurze, laengenangepasste Leitungen verwenden.
