scenz-dev/superpico-digital/src/audio/i2s_capture.c

/**
 * I2S Capture Implementation (Polling Mode)
 *
 * Uses PIO to capture I2S data from SNES S-DSP, polled from Core 1.
 * 24-bit I2S frames at ~32kHz (16-bit audio, right-justified).
 */

#include "i2s_capture.h"

#include "config.h"
#include "pico/time.h"

#include "hardware/dma.h"
#include "hardware/gpio.h"

#include <string.h>

#include "i2s_capture.pio.h"

#ifndef ENABLE_AUDIO_FRAME_RESYNC
#define ENABLE_AUDIO_FRAME_RESYNC 0
#endif

#ifndef ENABLE_AUDIO_INACTIVITY_RESTART
#define ENABLE_AUDIO_INACTIVITY_RESTART 0
#endif

// DMA buffer must be large enough to hold samples between polls
// At 32 kHz and 60 fps: ~1067 words/frame. Use 4096 for headroom.
#define I2S_DMA_BUFFER_SIZE 4096
#define I2S_DMA_BUFFER_MASK (I2S_DMA_BUFFER_SIZE - 1)

// Aligned buffer for DMA ring wrapping (4096 words = 16384 bytes)
static uint32_t g_dma_buffer[I2S_DMA_BUFFER_SIZE] __attribute__((aligned(16384)));

bool i2s_capture_init(i2s_capture_t *cap, const i2s_capture_config_t *config, ap_ring_t *ring)
{
    // Reserve the requested SM before allocating DMA or changing pins.
    // The dormant frequency counter must not silently reuse the audio SM.
    if (pio_sm_is_claimed(config->pio, config->sm)) return false;
    pio_sm_claim(config->pio, config->sm);
    cap->config = *config;
    cap->ring = ring;
    cap->samples_captured = 0;
    cap->overflows = 0;
    cap->running = false;
    cap->last_sample_count = 0;
    cap->last_measure_time = 0;
    cap->measured_rate = 0;

    // Initialize DMA state
    cap->dma_buffer = g_dma_buffer;
    cap->dma_buffer_idx = 0;
    cap->dma_chan = dma_claim_unused_channel(true);

    // Initialize GPIO pins as inputs BEFORE PIO takes over
    gpio_init(config->pin_bck);
    gpio_init(config->pin_dat);
    gpio_init(config->pin_ws);
    gpio_set_dir(config->pin_bck, GPIO_IN);
    gpio_set_dir(config->pin_dat, GPIO_IN);
    gpio_set_dir(config->pin_ws, GPIO_IN);

    // Disable pulls and enable Schmitt triggers for clean 5V-level signals
    gpio_disable_pulls(config->pin_bck);
    gpio_disable_pulls(config->pin_dat);
    gpio_disable_pulls(config->pin_ws);
    gpio_set_input_hysteresis_enabled(config->pin_bck, true);
    gpio_set_input_hysteresis_enabled(config->pin_dat, true);
    gpio_set_input_hysteresis_enabled(config->pin_ws, true);

    // GP22-24 are in Bank 0, use GPIOBASE=0
    // Note: video capture uses GPIOBASE=16 on PIO1. Audio uses PIO0 with GPIOBASE=0.
    pio_set_gpio_base(config->pio, 0);

    // Add PIO program
#if ENABLE_AUDIO_FRAME_RESYNC
    uint offset = pio_add_program(config->pio, &i2s_capture_frame_resync_program);
    cap->pio_offset = offset;
    i2s_capture_frame_resync_program_init(config->pio, config->sm, offset,
                                          config->pin_dat, config->pin_ws, config->pin_bck);
#else
    uint offset = pio_add_program(config->pio, &i2s_capture_program);
    cap->pio_offset = offset;

    // Initialize PIO state machine
    i2s_capture_program_init(config->pio, config->sm, offset,
                             config->pin_dat, config->pin_ws, config->pin_bck);
#endif

    // Configure DMA
    dma_channel_config c = dma_channel_get_default_config(cap->dma_chan);
    channel_config_set_read_increment(&c, false);
    channel_config_set_write_increment(&c, true);
    channel_config_set_dreq(&c, pio_get_dreq(config->pio, config->sm, false));
    channel_config_set_transfer_data_size(&c, DMA_SIZE_32);

    // Enable ring wrapping for destination (2^14 bytes = 16384 bytes = 4096 words)
    channel_config_set_ring(&c, true, 14);

    dma_channel_configure(cap->dma_chan, &c,
                          cap->dma_buffer,               // Destination
                          &config->pio->rxf[config->sm], // Source
                          0xFFFFFFFF,                     // Count (run "forever")
                          false                           // Don't start yet
    );

    return true;
}

void i2s_capture_start(i2s_capture_t *cap)
{
    if (cap->running)
        return;

    // Reset counters
    cap->samples_captured = 0;
    cap->overflows = 0;
    cap->last_sample_count = 0;
    cap->last_measure_time = time_us_64();
    cap->dma_buffer_idx = 0;

    // Force SM into a clean state
    pio_sm_set_enabled(cap->config.pio, cap->config.sm, false);
    pio_sm_restart(cap->config.pio, cap->config.sm);
    pio_sm_clear_fifos(cap->config.pio, cap->config.sm);

    // Jump to the start of the program (the sync preamble)
    pio_sm_exec(cap->config.pio, cap->config.sm, pio_encode_jmp(cap->pio_offset));

    // No buffer clear: the reset read index and restarted DMA write address
    // delimit fresh data. Clearing 16 KiB here stalls the HDMI background task.
    cap->measured_rate = 0;

    // Start DMA
    dma_channel_set_write_addr(cap->dma_chan, cap->dma_buffer, true);

    // Enable PIO state machine
    pio_sm_set_enabled(cap->config.pio, cap->config.sm, true);

    cap->last_activity_time = time_us_64();
    cap->running = true;
}

void i2s_capture_stop(i2s_capture_t *cap)
{
    if (!cap->running)
        return;

    // Stop DMA
    dma_channel_abort(cap->dma_chan);

    // Disable PIO state machine
    pio_sm_set_enabled(cap->config.pio, cap->config.sm, false);

    cap->running = false;
}

uint32_t i2s_capture_poll(i2s_capture_t *cap)
{
    if (!cap->running)
        return 0;

    uint32_t count = 0;
    uint64_t now = time_us_64();

    // Get current DMA write position from the WRITE_ADDR register
    uint32_t write_ptr = dma_hw->ch[cap->dma_chan].write_addr;
    uint32_t write_idx = (write_ptr - (uint32_t)(uintptr_t)cap->dma_buffer) / sizeof(uint32_t);

    // Read all samples written by DMA since last poll
    if (cap->dma_buffer_idx != write_idx) {
        cap->last_activity_time = now;

        // At most 32 stereo pairs per call; preserve the unread position.
        // Large backlogs must not monopolize HDMI background service.
        uint32_t processed = 0;
        while (cap->dma_buffer_idx != write_idx && processed < 32U) {
            // PIO pushes R then L. Need 2 words per stereo sample.
            uint32_t next_idx = (cap->dma_buffer_idx + 1) & I2S_DMA_BUFFER_MASK;
            if (next_idx == write_idx)
                break;  // Need at least 2 words

            uint32_t raw_r = cap->dma_buffer[cap->dma_buffer_idx];
            uint32_t raw_l = cap->dma_buffer[next_idx];
            cap->dma_buffer_idx = (next_idx + 1) & I2S_DMA_BUFFER_MASK;
            ++processed;

            // 16-bit right-justified: audio is in lower 16 bits
            audio_sample_t sample;
            sample.left = (int16_t)(raw_l & 0xFFFF);
            sample.right = (int16_t)(raw_r & 0xFFFF);

            if (ap_ring_free(cap->ring) > 0) {
                ap_ring_write(cap->ring, sample);
                cap->samples_captured++;
                count++;
            } else {
                cap->overflows++;
            }
        }
    }
#if ENABLE_AUDIO_INACTIVITY_RESTART
    else {
        if (now - cap->last_activity_time > 200000) {
            i2s_capture_stop(cap);
            i2s_capture_start(cap);
            cap->last_activity_time = now;
            return 0;
        }
    }
#endif

    // Update sample rate measurement
    uint64_t elapsed = now - cap->last_measure_time;
    if (elapsed >= 500000) {
        uint32_t samples_since = cap->samples_captured - cap->last_sample_count;
        cap->measured_rate = (uint32_t)((uint64_t)samples_since * 1000000 / elapsed);
        cap->last_sample_count = cap->samples_captured;
        cap->last_measure_time = now;
    }

    return count;
}

uint32_t i2s_capture_get_sample_rate(i2s_capture_t *cap)
{
    return cap->measured_rate;
}
