scenz-dev/superpico-digital/src/video/video_capture.h

#ifndef VIDEO_CAPTURE_H
#define VIDEO_CAPTURE_H

#include <stdint.h>

/**
 * Initialize SNES video capture hardware
 */
void video_capture_init(void);

/**
 * Run video capture loop (never returns)
 */
void video_capture_run(void);

/**
 * Get current captured frame count
 */
uint32_t video_capture_get_frame_count(void);

uint32_t video_capture_get_profile(void);

#endif // VIDEO_CAPTURE_H
