scenz-dev/superpico-digital/(commit log)

2026-11-12 Add automatic PAL/NTSC capture and HDMI output selection
    Detect PPU timing and 224/239-line input, select 576p50 or 480p60 in Auto mode, and publish only complete frames. Add capture recovery and fix RGB565 conversion, audio SRC/backpressure, and resolution confirmation persistence.
    Keep the HDMI submodule unchanged using a pinned build-time adaptation. Include host regression tests and hardware acceptance documentation.
    Validated: RP2350 Release build with Pico SDK 2.2.0, host UBSan tests, patch application, and diff checks. Physical console/HDMI validation remains pending.
    [audio_pipeline.c, input_timing.h, line_ring.h, main.c, menu_diag_experiment.c]
2026-11-12 Audit remaining hardware gaps and bound audio DMA polling
    Reserve the audio PIO state machine, limit background DMA consumption and avoid clearing the full DMA buffer during restart. Correct stale board/audio documentation and distinguish proposed brightness/Mode7 circuitry from implemented fixes.
    ARM Release build and existing host regression suites pass. Physical DMA/audio and PPU signal validation remains outstanding.
    [i2s_capture.c]
2026-11-12 Add review-stage KiCad SNES interface with level shifting and mode register capture
    [BOM.csv, GPIO.csv, bias.kicad_sch, bus.kicad_sch, decode.kicad_sch, host.kicad_sch, latches.kicad_sch, logic.kicad_sch]
